andres-tr/BoreholeCamera/README.md

# Borehole Camera

This project aims to create a device capable of exploring water boreholes.
