andres-tr/BoreholeCamera/CAD_Probe/README.md

# Probe CAD

For the probe design it is desired to achieve the following:

 - Waterproof (1000m = 9.883MPa).
 - 90ºC temperature resistant.
 - Low hydronynamic resistance to prevent vibrations while recording.

**Computer asisted desing so far**
 - Explosion
<p align="center">
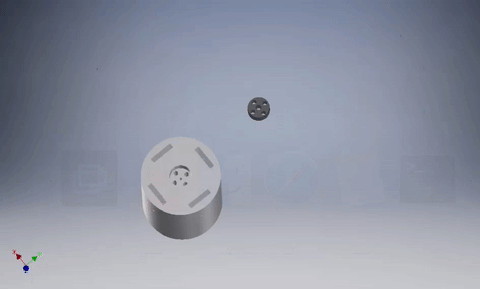
[picture p1: img/Explosion1.gif]
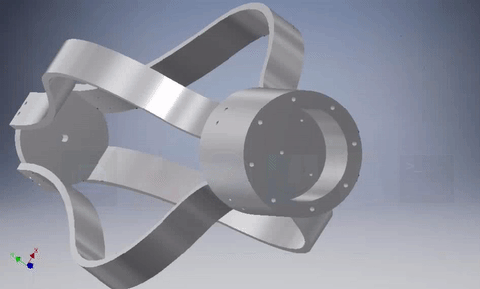
[picture p2: img/Explosion2.gif]
  
</p>

 - Assembly
<p align="center">
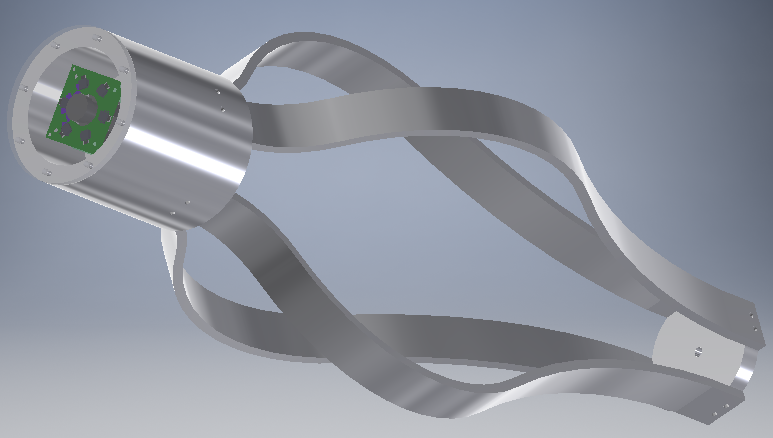
[picture p3: img/Assembly1.png]
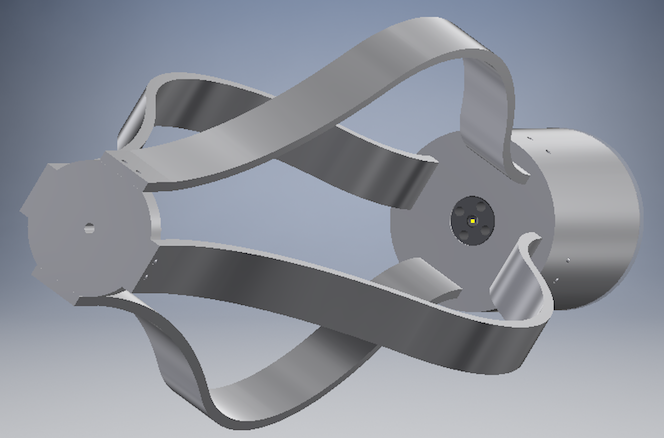
[picture p4: img/Assembly2.png]
  
</p>

 - Section View
<p align="center">
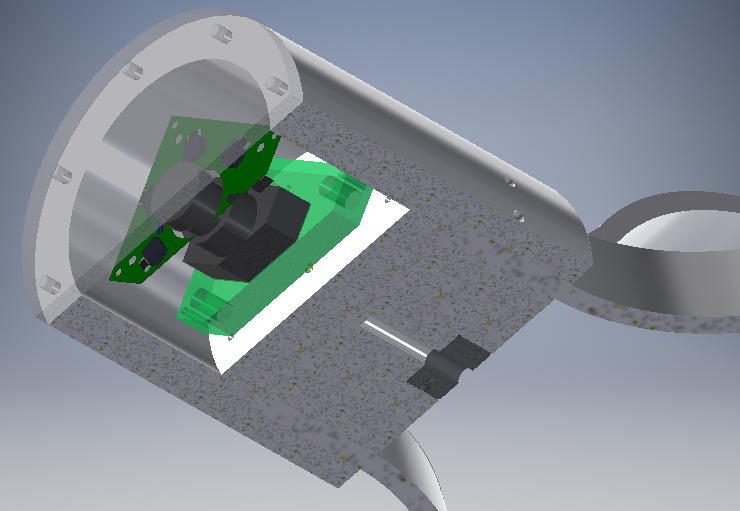
[picture p5: img/SectionView1.png]
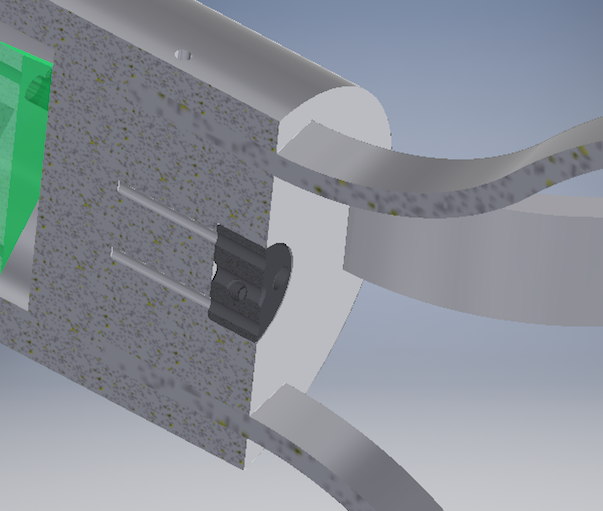
[picture p6: img/SectionView2.png]
  
</p>

**Note:**
