andres-tr/BoreholeCamera/PCB_Probe/README.md

# Probe PCB

Electronics inside the probe have the following characteristics:

 - 750 lumens
 - Minimum power consumption in order to preserve cable condition 
 - PCB designed to provide LEDs around the camera lens evenly

Top side of the PCB

<p align="center">
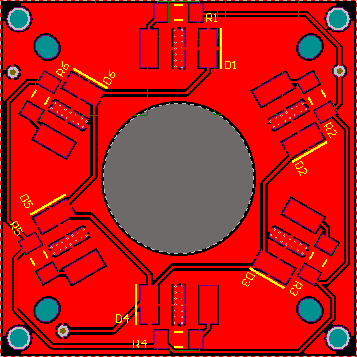
[picture p7: img/PCB_Probe_Top2D.png]
  
</p>

Bottom side of the PCB
<p align="center">
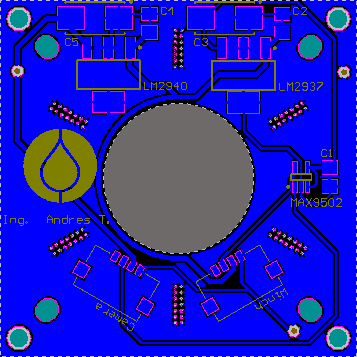
[picture p8: img/PCB_Probe_Bottom2D.png]
  
</p>
