andres-tr/BoreholeCamera/CAD_Probe/PCB/README.md

> - Top side of the PCB

<p align="center">
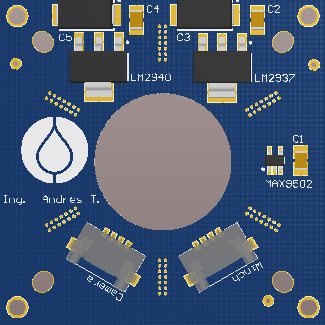
[picture p9: img/PCB_Probe_Top3D.png]
  
</p>

> - Bottom side of the PCB

<p align="center">
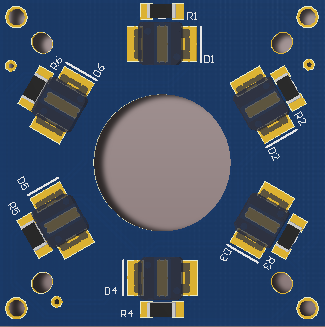
[picture p10: img/PCB_Probe_Bottom3D.png]
  
</p>
