andres-tr/BoreholeCamera/BOM/BOM_Enclosure_Probe.xls

Sheet: Fasteners
Part | Assembly part | Head size | Tool | Lg. | Threaded Lg. A | Thread | Gender | Fit Class | Threaded Lg. B | Thread | Gender | Fit Class | Material | QTY | Extended QTY | Description | Pack size | Number of Packs/Units | McMaster-Carr Part Number | Price Unit/Pack | Extended
6-32 Socket Head Cap Screw | Top cover Screws | 0.226” | 7/64” Hex | 1 1/4” | 1 1/4” | #6-32 | Male | 3A | - | - | - | - | 316 Stainless Steel | 8 | 16 | Type 316 Stainless Steel Socket Head Cap Screw, 6-32 Thread, 1-1/4" Long, Fully Threaded | 10 | 2 | 92185A157 | $6.62 | $13.24
1” long Female Threaded 3/16” Hex Standoff | Camera + LEDS Standoff | 3/16” (Hex) | 3/16” Hex | 1” | 3/16” | #2-56 | Female | 2B | 3/16” | #2-56 | Female | 2B | 18-8 Stainless Steel | 4 | 8 | 18-8 Stainless Steel Female Threaded Hex Standoff, 3/16" Hex Size, 1" Length, 2-56 Thread Size | 1 | 8 | 91115A115 | $2.34 | $18.72
Male Female Threaded Hex Standoff | Camera + LEDS Standoff | 3/16” (Hex) | 3/16” (Hex) | 1” | 3/16” | #2-56 | Female | 2B | 5/32” | #2-56 | Male | 2A | 18-8 Stainless Steel | 4 | 8 | 18-8 Stainless Steel Male-Female Threaded Hex Standoff, 3/16" Hex Size, 1" Length, 2-56 Thread Size | 1 | 8 | 91075A217 | $2.22 | $17.76
2-56 Socket Head Cap Screws | Camera + LEDS fasteners | 0.14” | 5/64” Hex | 1/8” | 1/8” | #2-56 | Male | 3A | - | - | - | - | 316 Stainless Steel | 10 | 20 | Type 316 Stainless Steel Socket Head Cap Screw, 2-56 Thread, 1/8" Long | 10 | 2 | 92185A071 | $5.25 | $10.50
Male Female Threaded Hex Standoffs | Camera + Enclosure Standoff | 3/16” (Hex) | 3/16” Hex | - | 5/32” | #2-56 | Male | 2A | 3/16” | #2-56 | Female | 2B | 18-8 Stainless Steel | 4 | 8 | 18-8 Stainless Steel Male-Female Threaded Hex Standoff, 3/16" Hex Size, 3/8" Length, 2-56 Thread Size | 1 | 8 | 91075A212 | $2.16 | $17.28
2-56 Socket Head Cap Screws | Camera + Enclosure Fasteners | 0.14” | 5/64” Hex | 1/8” | 1/8” | #2-56 | Male | 3A | - | - | - | - | 316 Stainless Steel | 4 | 8 | Type 316 Stainless Steel Socket Head Cap Screw, 2-56 Thread, 1/8" Long | 10 | 1 | 92185A071 | $8.62 | $8.62
6-32 High Hold Cone Point Set Screw | Enclosure + Cable Fasteners | 0.138” | 1/16” Hex | 1/2” | 1/2” | #6-32 | Male | 3A | - | - | - | - | 18-8 Stainless Steel | 8 | 16 | High Hold Cone Point Set Screw, 18-8 Stainless Steel, 6-32 Thread, 1/2" Long | 25 | 1 | 92785A148 | $5.89 | $5.89
Cup Point Set Screw | Enclosure + Fins Fastener | 0.138” | 1/16” Hex | 3/4” | 3/4” | #6-32 | Male | 3A | - | - | - | - | 18-8 Stainless Steel | 8 | 16 | Type 316 Stainless Steel Cup Point Set Screw, 6-32 Thread, 3/4" Long | 25 | 1 | 92313A154 | $7.32 | $7.32
Cup Point Set Screw | Bottom part + Fins Fasteners | 0.138” | 1/16” Hex | 5/8” | 5/8” | #6-32 | Male | 3A | - | - | - | - | 316 Stainless Steel | 4 | 8 | Type 316 Stainless Steel Cup Point Set Screw, 6-32 Thread, 5/8" Long | 25 | 1 | 92313A412 | $6.55 | $6.55
Male – Female Standoff 3.25 mm (0.1279528”) | Winch PCB Standoff | 3/16” (Hex) | 3/16” Hex | - | 1/4” | #6-32 | Male | 2A | 3/8” | #6-32 | Female | 2B | 18-8 Stainless Steel | 4 | 8 | 18-8 Stainless Steel Male-Female Threaded Hex Standoff, 3/16" Hex Size, 3/8" Length, 6-32 Thread Size | 1 | 8 | 91075A112 | $2.16 | $17.28
Male – Female Standoff 6-32 | Winch PCB Standoff | 3/16” (Hex) | 3/16” Hex | - | 1/8” | #6-32 | Male | 2B | 1/4” | #6-32 | Female | 2A | 18-8 Stainless Steel | 4 | 8 | 18-8 Stainless Steel Male-Female Threaded Hex Standoff, 3/16" Hex Size, 1/8" Length, 6-32 Thread Size | 1 | 8 | 91075A874 | $0.98 | $7.84 | *
Narrow Hex nut | Camera lens | 5/32” | 5/32” Hex | - | - | #0-80 | Female | 2B | - | - | - | - | 18-8 Stainless Steel | 2 | 4 | Mil. Spec. 300 Series Stainless Steel Hex Nut, 0-80 Thread Size, 5/32" Wide, 3/64" High, MS-35650-314 | 5 | 1 | 91240A001 | $8.41 | $8.41
Head Cap Screw | Camera lens | 0.05” (Hex) | 0.05” (Hex) | 1/2” | 1/2” | #0-80 | Male | 3A | - | - | - | - | 316 Stainless Steel | 2 | 4 | Type 316 Stainless Steel Socket Head Cap Screw, 0-80 Thread, 1/2" Long | 10 | 1 | 92185A055 | $5.67 | $5.67
Female Standoff | Winch cable holder | 3/16” (Hex) | 3/16” (Hex) | 1” | 3/16” | #2-56 | Female | 2B | 3/16” | #2-56 | Female | 2B | 18-8 Stainless Steel | 5 | 2 | 18-8 Stainless Steel Female Threaded Hex Standoff, 3/16" Hex Size, 1" Length, 2-56 Thread Size | 1 | 2 | 91115A115 | $2.34 | $4.68
 |  |  |  |  |  |  |  |  |  |  |  |  |  |  |  |  |  |  |  | Total | $149.76

Sheet: Tools
Part | Size | For driver style | Driver type | Style | Long Leg | Short Leg | Material | McMaster-Carr Part Number | Description | Pack size | Price Unit/Pack
High-visibility Gold L-Keys 7/64” | 7/64” Hex | Hex | Standard | L-Key | 3 5/8” | 3/4” | Gold-plated steel | 6493A67 | High-Visibility Gold L-Key, 7/64" Size | 1 | $0.61
Precise-control nutdriver 5/32” | 5/32” | 5/32” Hex | Standard | Driver | 2 3/8” | - | Chrome-Plated Steel | 7278A37 | Precise-Control Nutdriver, 5/32" Size | 1 | $5.11
Precise-control nutdrivers 3/16” | 3/16” (Hex) | 3/16” | Standard | Driver | 2 3/8” | - | Chrome-Plated Steel | 7278A38 | Precise-Control Nutdriver, 3/16" Size | 1 | $5.29
High visibility Gold L-Keys 3/16” | 3/16” Hex | Hex | Standard | L-Key | 4 1/2” | 1” | Gold-plated steel | 6493A72 | High-Visibility Gold L-Key, 3/16" Size | 1 | $1.05
High visibility Gold L-Keys 1/8” | 1/8” Hex | Hex | Standard | L-Key | 3 13/16” | 3/4” | Gold-plated steel | 6493A68 | High-Visibility Gold L-Key, 1/8" Size | 1 | $0.61
High visibility Gold L-Keys 1/16” | 1/16” Hex | Hex | Standard | L-Key | 3” | 9/16” | Gold-plated steel | 6493A64 | High-Visibility Gold L-Key, 1/16" Size | 1 | $0.49
Hex L-Key | 0.05 Hex | Hex | Standard | L-Key | 1 5/8” | 9/16” | Steel (Black) | 7122A13 | Hex L-Key, 0.050" Size, 1-11/16" Overall Length | 1 | $0.14
Hex L-Key | 5/64” Hex | Hex | Standard | L-Key | 1 15/16” | 5/8”” | Steel (Black) | 7122A15 | Hex L-Key, 5/64" Size, 2-1/16" Overall Length | 1 | $0.16
 |  |  |  |  |  |  |  |  |  | Total | $13.46

Sheet: Seal
Part | Size | Style | Material | Apple Part Number | Description | QTY | Price Unit | Extended
O-ring (1) | 0.087 x 0.059” | O-ring | Nitril | R00087-059-70BNB | O-ring, .087 x .059 Nitrile, 70A | 20 | $2.60 | $52.00
O-ring (2) | 2.489 x 0.07” | O-ring | Nitril | R02489-070-70BNB | AS568-037 Nitrile, 70A | 20 | $3.00 | $60.00
 |  |  |  |  |  |  | Total | $112.00
