andres-tr/BoreholeCamera/BOM/BOM_PCB.xls

Sheet: PCB_Winch
WINCH
Part | Size/Package | QTY | Extended QTY | Digi-Key Part Number | Manf | Manf Part Number | Description | Price Unit | Extended
MAX7456 | 28-TSSOP | 1 | 4 | MAX7456EUI+-ND | Maxim Integrated | MAX7456EUI+ | IC ON-SCREEN DISPLAY 28-TSSOP | 18.22 | 72.88
27MHZ Crystal | 2-SMD | 1 | 4 | 535-10646-1-ND | Abracon LLC | ABM3-27.000MHZ-D2Y-T | CRYSTAL 27.0000MHZ 18PF SMD | 1.09 | 4.36
0.1 uf Capacitor | 0805 (2012 Metric) | 4 | 16 | 399-1167-1-ND | Kemet | C0805C104K4RACTU | CAP CER 0.1UF 16V X7R 0805 | 0.11 | 1.76
47uf Capacitor | 2917 (7343 Metric) | 2 | 8 | 399-3795-1-ND | Kemet | T491D476K020AT | CAP TANT 47UF 20V 10% 2917 | 1.3 | 10.4
1KΩ Resistor | 0805 (2012 Metric) | 3 | 12 | 311-1.00KCRCT-ND | Yageo | RC0805FR-071KL | RES SMD 1K OHM 1% 1/8W 0805 | 0.1 | 1.2
Female Connector 4 circuits | - | 2 | 8 | WM10655CT-ND | Molex, LLC | 5037630491 | CONN HEADER 1MM R/A 4CKT | 1.13 | 9.04
Male connector 4 circuit | - | 2 | 8 | WM10653-ND | Molex, LLC | 5037640401 | CONN HOUSING 4POS LK | 0.41 | 3.28
Connector Molex (For 4 circuits connectors) | - | 8 | 45 | WM10651CT-ND | Molex, LLC | WM10651CT-ND | CONN TERM FEMALE 28,30AWG | 0.17 | 7.65
Male Conector 7 circuits | - | 1 | 4 | WM10144CT-ND | Molex, LLC | 5040500791 | 7 Positions Header, Shrouded Connector 0.059" (1.50mm) Surface Mount, Right Angle Gold | 1.52 | 6.08
Female Conector 7 circuits | - | 1 | 4 | WM10142-ND | Molex, LLC | 5040510701 | CONN HOUSING 7POS LK | 0.52 | 2.08
Connector Molex (For 7 circuits connectors) | - | 7 | 35 | WM10651CT-ND | Molex, LLC | WM10651CT-ND | CONN TERM FEMALE 28,30AWG | 0.17 | 5.95
Fuse 1A | - | 2 | 8 | 507-1186-1-ND | Bel Fuse Inc. | C1S 1 | FUSE BOARD MNT 1A 63VAC/VDC 1206 | 0.35 | 2.8
Tactile switch | SMD (SMT) Tab | 3 | 12 | P12970SCT-ND | Panasonic Electronic Components | EVQ-Q2F02W | SWITCH TACTILE SPST-NO 0.02A 15V | 0.4 | 4.8
Regu 8V step down | SOT-223-4 | 1 | 4 | 296-41299-1-ND | Texas Instruments | LM2940IMPX-8.0/NOPB | IC REG LDO 8V 1A SOT223 | 2.11 | 8.44
10KΩ Resistor | 0805 (2012 métrico) | 1 | 4 | P16897CT-ND | Panasonic Electronic Components | ERJ-P6WF1002V | RES SMD 10K OHM 1% 1/2W 0805 | 0.59 | 2.36
0.47uf Capacitor | 0805 (2012 Metric) | 1 | 4 | 399-8123-1-ND | Kemet | C0805X474K5RACTU | 0.47µF ±10% 50V X7R Ceramic Capacitor -55°C ~ 125°C Surface Mount, MLCC 0805 (2012 Metric) 0.079" L x 0.049" W (2.00mm x 1.25mm) | 0.72 | 2.88
22uf | 2413 (6032 Metric) | 1 | 4 | 399-3745-1-ND | Kemet | T491C226K020AT | CAP TANT 22UF 20V 10% 2413 | 0.8 | 3.2
Conector (encoder) | - | 1 | 2 | AIMS3106F16S-1S W/P CAP-ND | Amphenol Industrial Operations | MS3106F16S-1S W/P CAP | ER 7C #16S SKT PLUG | 40.54 | 81.08
Video Connector | - | 3 | 12 | CP-1421-ND | CUI Inc. | RCJ-044 | CONN RCA JACK MONO 3.2MM R/A | 1.78 | 21.36
Intel Edison receptacle | - | 1 | 4 | H11908CT-ND | Hirose Electric Co Ltd | DF40C(2.0)-70DS-0.4V(51) | CONN RCPT 70POS 0.4MM SMD GOLD | 1.37 | 5.48
Power jack connector dip | - | 1 | 4 | A118043CT-ND | TE Connectivity AMP Connectors | 1-2129345-1 | DC POWER JACK CONN DIP TYPE | 2.62 | 10.48
Power jack plug connector | - | 1 | 4 | A118213-ND | TE Connectivity AMP Connectors | 1-2129334-1 | DC POWER PLUG CONN | 2.48 | 9.92
Headers 10 circuits | - | 2 | 8 | 952-1843-ND | Harwin Inc. | M20-9991046 | 10 Positions Header, Unshrouded, Breakaway Connector 0.100" (2.54mm) Through Hole Tin | 0.29 | 2.32
Headers 6 circuits | - | 2 | 8 | A106757-ND | TE Connectivity AMP Connectors | 826926-6 | 6 Positions Header, Unshrouded, Breakaway Connector 0.100" (2.54mm) Through Hole Tin | 0.44 | 3.52
Female Conector 2 Circuits for push buttons | - | 3 | 12 | WM10652-ND | Molex, LLC | 5037640201 | CONN HOUSING 2POS LK | 0.22 | 2.64
Male Conector 2 Circuits for push buttons | - | 3 | 12 | WM10654CT-ND | Molex, LLC | 5037630291 | 2 Positions Header, Shrouded Connector 0.039" (1.00mm) Surface Mount, Right Angle Gold | 0.83 | 9.96
Connector Molex for 2 circuits | - | 6 | 28 | WM10651CT-ND | Molex, LLC | WM10651CT-ND | CONN TERM FEMALE 28,30AWG | 0.17 | 4.76
Extended quantity 4 PCB
Part | Size/Package | QTY | Extended QTY | Newark Part Number | Manf | Manf Part Number | Description | Price Unit | Extended
1k res | 0805 [2012 Metric] | 3 | 20 | 65J1337 | vishay | CRCW08051K00JNEB | The Vishay D/CRCW e3 series are standard thick film chip resistors. | 0.105 $ | 2.100 $
330 ohm 1W (290OHMS 0.029W) | 0805 [2012 Metric] | 1 | 10 | 58K4809 | multicomp | MC01W08051330R | 100mW 150v | 0.003 $ | 0.030 $
RES 300 ohms (290 0.029W) | 0603 [1608 Metric] | 1 | 10 | 58K4556 | multicomp | MC0063W06031300R | 63mW 50 V | 0.002 $ | 0.020 $
RES 75 ohm | 0805 [2012 Metric] | 2 | 25 | 65T8842 | Panasonic Electronic Components | ERJ-6GEYJ750V | 125mW 150V 75ohm | 0.004 $ | $0.10

Sheet: PCB_Probe
PROBE
Part | Size/Package | QTY | Extended QTY | Digi-Key Part Number | Manf | Manf Part Number | Description | Price Unit | Extended
MAX9502M 12DB | 5-TSSOP, SC-70-5, SOT-353 | 1 | 4 | MAX9502MEXK+TCT-ND | Maxim Integrated | MAX9502MEXK+T | IC AMP VIDEO W/FILTER SC70-5 | 1.22 | 4.88
0.1 uf Capacitor | 0805 (2012 Metric) | 2 | 8 | 399-1167-1-ND | Kemet | C0805C104K4RACTU | CAP CER 0.1UF 16V X7R 0805 | 0.11 | 0.88
Female Connector | - | 2 | 8 | WM10655CT-ND | Molex, LLC | 5037630491 | CONN HEADER 1MM R/A 4CKT | 1.13 | 9.04
Male connector | - | 2 | 8 | WM10653-ND | Molex, LLC | 5037640401 | CONN HOUSING 4POS LK | 0.41 | 3.28
Connector Molex | - | 16 | 70 | WM10651CT-ND | Molex, LLC | WM10651CT-ND | CONN TERM FEMALE 28,30AWG | 0.17 | 11.9
Reg 3.3V | SOT-223 | 1 | 4 | LM2937IMP-3.3CT-ND | Texas Instruments | LM2937IMP-3.3 | IC REG LDO 3.3V 0.4A SOT223 | 2.11 | 8.44
cap 10uF | 2413 (6032 Metric) | 1 | 4 | 399-3732-1-ND | Kemet | T491C106K016AT | CAP TANT 10UF 16V 10% 2413 | 0.53 | 2.12
LED neutral White | 2-SMD | 6 | 24 | MX3SWT-A1-0000-000CE5CT-ND | Cree Inc. | MX3SWT-A1-0000-000CE5 | LED XLAMP NEUTRAL WHT 4000K 2SMD | 1.33 | 31.92
LED cool white | 2-SMD | 6 | 24 | MX3SWT-A1-0000-000E51CT-ND | Cree Inc. | MX3SWT-A1-0000-000E51 | LED XLAMP COOL WHITE 6500K 2SMD | 2.24 | 53.76
LED white warm | 2-SMD | 6 | 24 | MX3SWT-A1-R250-000BE7CT-ND | Cree Inc. | MX3SWT-A1-R250-000BE7 | LED XLAMP WARM WHITE 3000K 2SMD | 1.22 | 29.28
Res 12 ohm | 1206 (3216 Metric) | 6 | 24 | P12ECT-ND | Panasonic Electronic Components | ERJ-8GEYJ120V | RES SMD 12 OHM 5% 1/4W 1206 | 0.1 | 2.4
Reg 12V step down | SOT-223-4 | 1 | 4 | LM2940IMP-12/NOPBCT-ND | Texas Instruments | LM2940IMP-12/NOPB | IC REG LDO 12V 1A SOT223 | 2.11 | 8.44
0.47uf Capacitor | 0805 (2012 Metric) | 1 | 4 | 399-8123-1-ND | Kemet | C0805X474K5RACTU | 0.47µF ±10% 50V X7R Ceramic Capacitor -55°C ~ 125°C Surface Mount, MLCC 0805 (2012 Metric) 0.079" L x 0.049" W (2.00mm x 1.25mm) | 0.72 | 2.88
22uf | 2413 (6032 Metric) | 1 | 4 | 399-3745-1-ND | Kemet | T491C226K020AT | CAP TANT 22UF 20V 10% 2413 | 0.8 | 3.2
*Extended quantity 4 PCB

Sheet: Tools
Tools
Part | QTY | Newark Part Number | Manf | Manf Part Number | Description | Price Unit | Extended
Adjustable Wrist strap scs | 1 | 39M5815 | SCS | ECWS61M-1 | The ECWS61M-1 is an Adjustable Fabric Wristband with 6ft cord. This economy wrist strap provides a cost effective means of grounding production staff. Features an adjustable fabric wristband, a 6 foot retractable coil cord, a 4mm snap and a spinning banana plug. | $7.36 | $7.36
Straight Tweezers | 1 | 48F2399 | Erem | EROPSSSA | Stainless Steel Punta Recta Puntiaguda | $5.66 | $5.66
Curved Tweezers | 1 | 71C3124 | Duratool | 1PK-106T-F | Stainless Steel | $5.75 | $5.75
Solder paste | 1 | 84R8667 | Chip Quick | SMD291SNL10 | Solder Paste, Water Washable, 217 C, 35 g | $36.81 | $36.81
Flux pen | 2 | 82H2047 | Kester | 83-1000-0951 | low-solid no-clean Flux Pen, specifically designed for rework of conventional and surface mount circuit board assemblies. | $13.02 | $26.04
Hot air rework station | 1 | 93T8993 | Tenma | 21-11425 | The 21-11425 is a compact-sized hot air Rework Station with closed loop control, LED display and modulated air flow making it ideal for multiple applications. Fast and stable temperature rise add to the convenience. | $102.29 | $102.29
Micropoint long soldering tip | 2 | 51F3536 | Weller | ET-S | The ET-S from Weller is a micropoint long soldering tip. This tip is used with Weller LR soldering iron. | $5.08 | $10.16
Wire cutter | 1 | 39C0516 | MCM | 22-595 | Wire cutter | $8.35 | $8.35
