andres-tr/BoreholeCamera/CAD_Probe/Assembly/STL/Assembly.stl

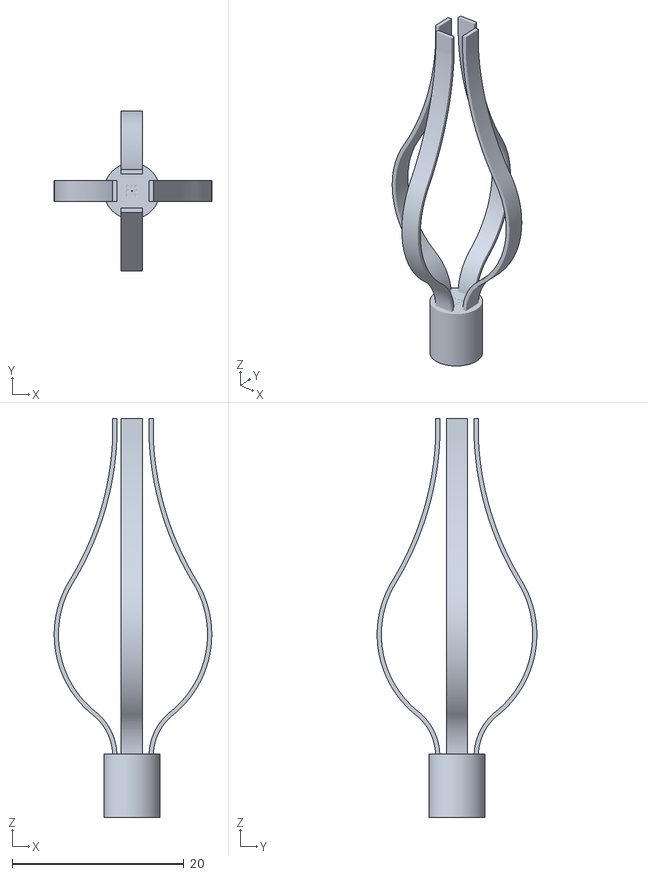
[picture p11: CAD file, 2016-06-02]
CAD_Probe/Assembly/STL/Assembly.stl
18.4 x 18.6 x 46.5
