andres-tr/BoreholeCamera/CAD_Probe/Camera/Assembly/STEP/Assembly.stp

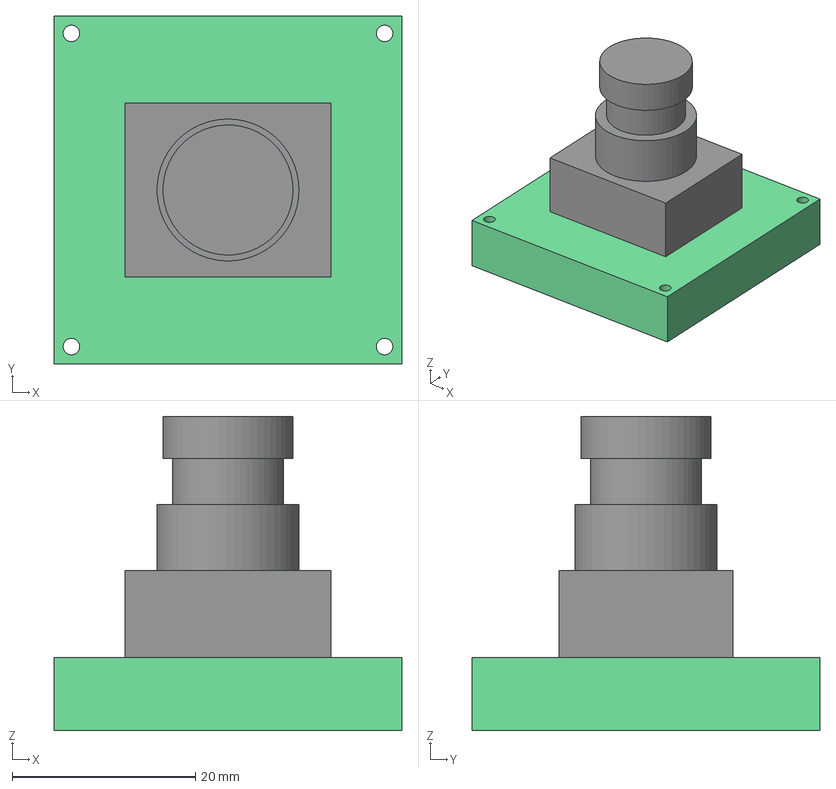
[picture p12: CAD file, 2016-04-14]
CAD_Probe/Camera/Assembly/STEP/Assembly.stp
38.0 x 38.0 x 34.3 mm
PCB_Camera
Camera
