andres-tr/BoreholeCamera/CAD_Probe/Camera/Parts/STEP/Camera.stp

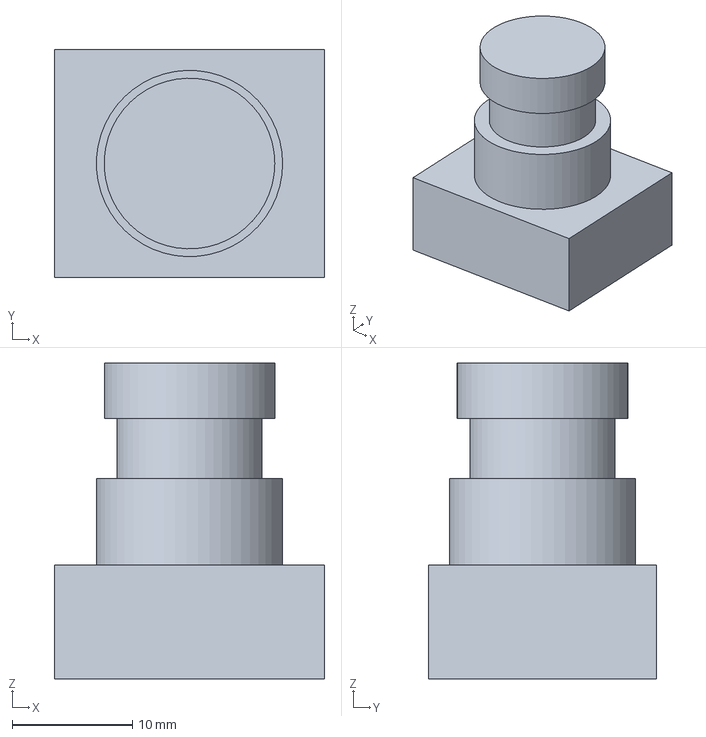
[picture p13: CAD file, 2016-04-14]
CAD_Probe/Camera/Parts/STEP/Camera.stp
22.5 x 19.0 x 26.3 mm
