andres-tr/BoreholeCamera/CAD_Probe/Enclosure/Parts/STL/Cover.stl

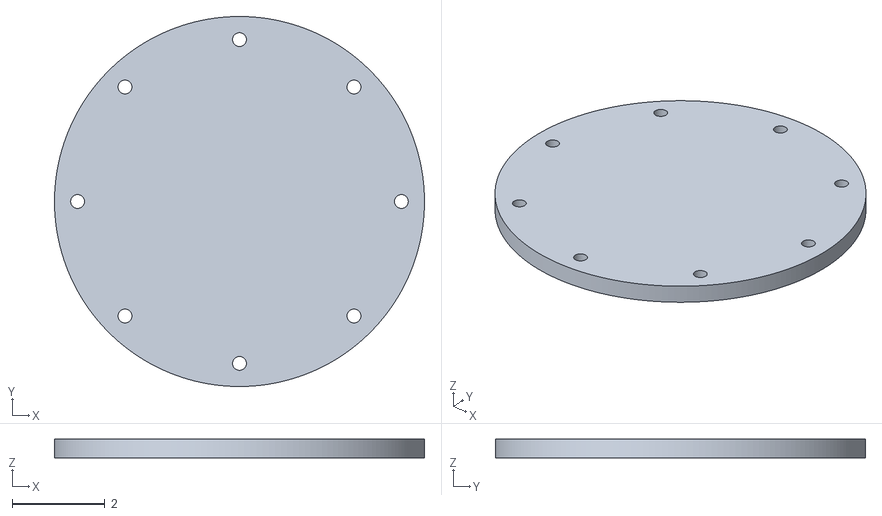
[picture p14: CAD file, 2016-06-25]
CAD_Probe/Enclosure/Parts/STL/Cover.stl
8.00 x 8.00 x 0.4
