andres-tr/BoreholeCamera/CAD_Probe/Laser/stl/laserCapBottom.stl

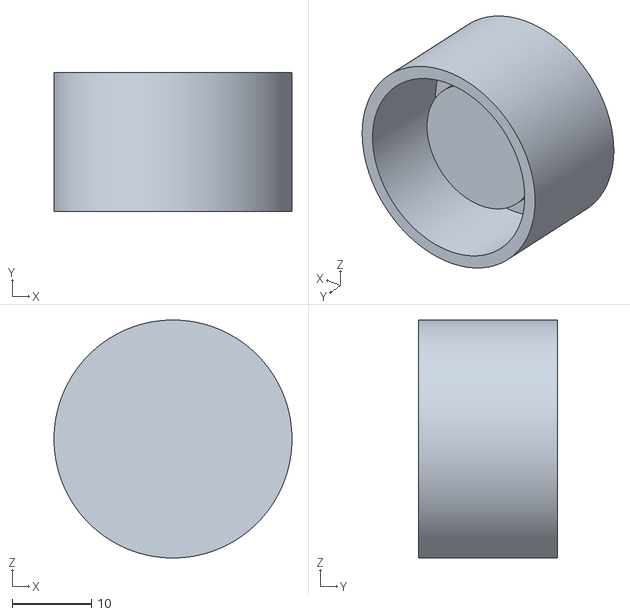
[picture p15: CAD file, 2018-11-16]
CAD_Probe/Laser/stl/laserCapBottom.stl
30.0 x 17.5 x 30.0
