andres-tr/BoreholeCamera/CAD_Probe/PCB/STL/PCB_Probe.stl

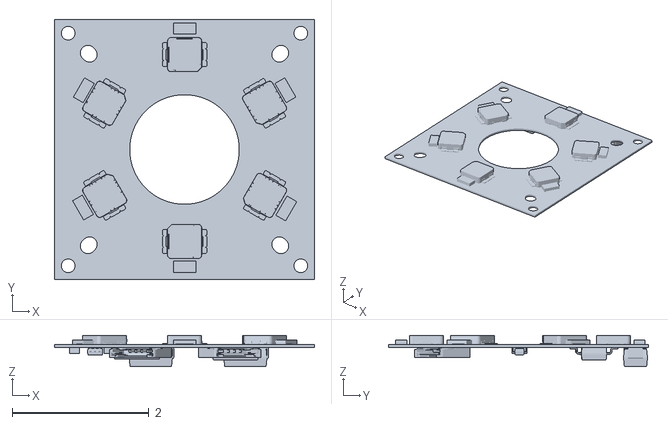
[picture p16: CAD file, 2016-06-25]
CAD_Probe/PCB/STL/PCB_Probe.stl
3.80 x 3.80 x 0.456
