andres-tr/BoreholeCamera/CAD_Probe/Camera/Parts/STEP/PCB_Camera.stp

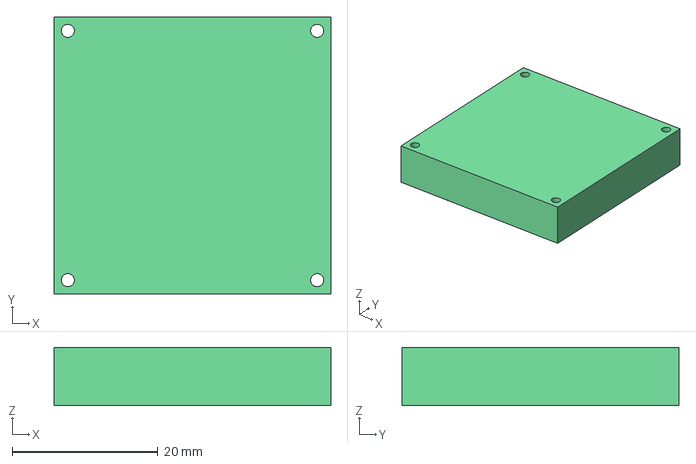
[picture p17: CAD file, 2016-04-14]
CAD_Probe/Camera/Parts/STEP/PCB_Camera.stp
38.0 x 38.0 x 8.00 mm
