andres-tr/BoreholeCamera/CAD_Probe/Enclosure/Parts/STL/Enclosure.stl

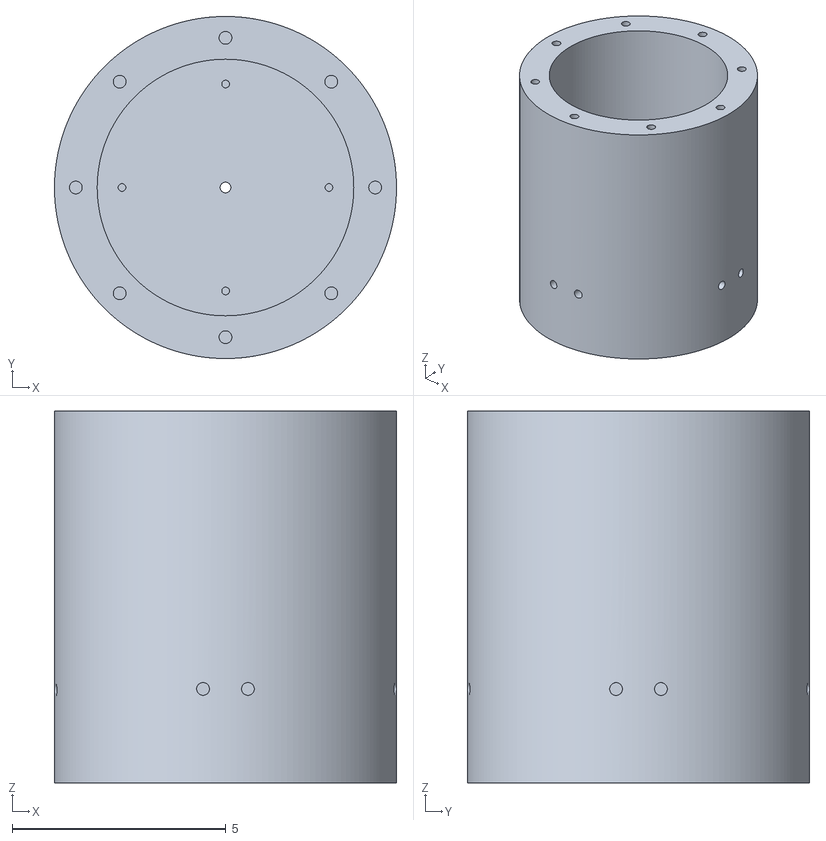
[picture p18: CAD file, 2016-06-25]
CAD_Probe/Enclosure/Parts/STL/Enclosure.stl
8.00 x 8.00 x 8.70
