andres-tr/BoreholeCamera/CAD_Probe/Laser/stl/laserNut.stl

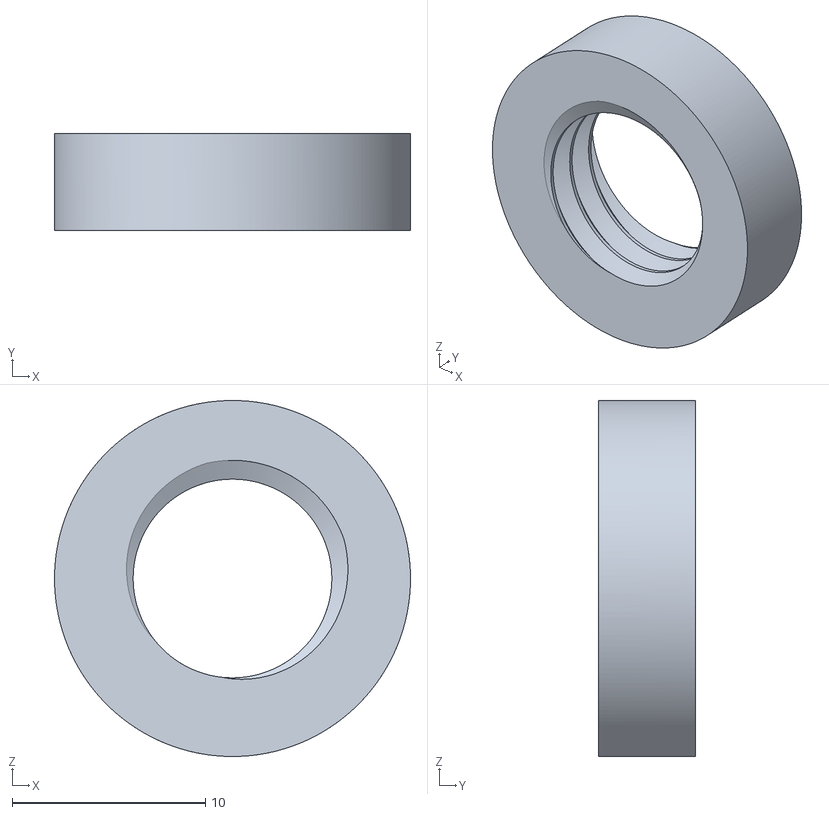
[picture p19: CAD file, 2018-11-16]
CAD_Probe/Laser/stl/laserNut.stl
18.4 x 5.00 x 18.4
