andres-tr/BoreholeCamera/CAD_Probe/Enclosure/Parts/STL/Bottom.stl

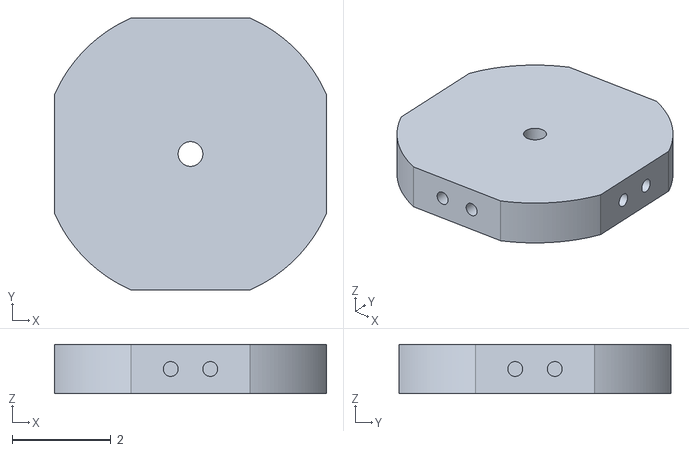
[picture p20: CAD file, 2016-06-25]
CAD_Probe/Enclosure/Parts/STL/Bottom.stl
5.50 x 5.50 x 1.00
