andres-tr/BoreholeCamera/CAD_Probe/Laser/stl/laserCapTop.stl

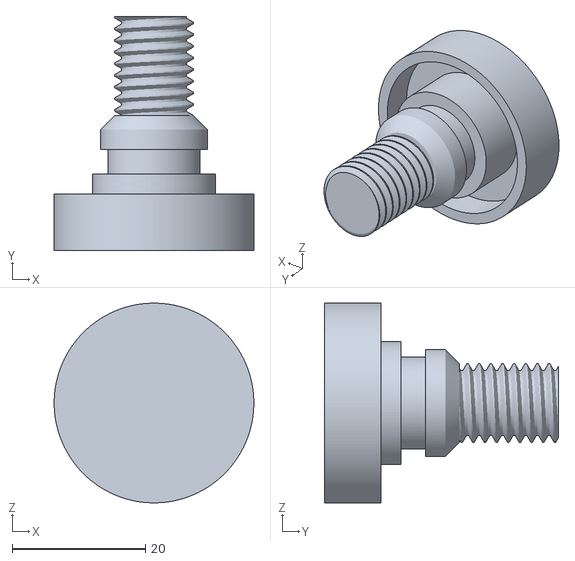
[picture p21: CAD file, 2018-11-16]
CAD_Probe/Laser/stl/laserCapTop.stl
30.0 x 35.2 x 30.0
