andres-tr/BoreholeCamera/CAD_Probe/Enclosure/Parts/STL/8inch_Fin.stl

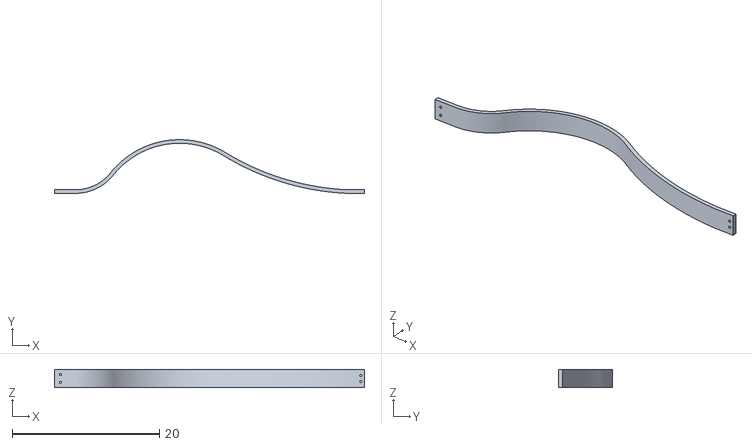
[picture p22: CAD file, 2016-06-25]
CAD_Probe/Enclosure/Parts/STL/8inch_Fin.stl
42.2 x 7.30 x 2.50
