andres-tr/BoreholeCamera/CAD_Probe/Assembly/Fasteners/STEP/92313A412_TYPE 316 SS CUP POINT SET SCREW.STEP

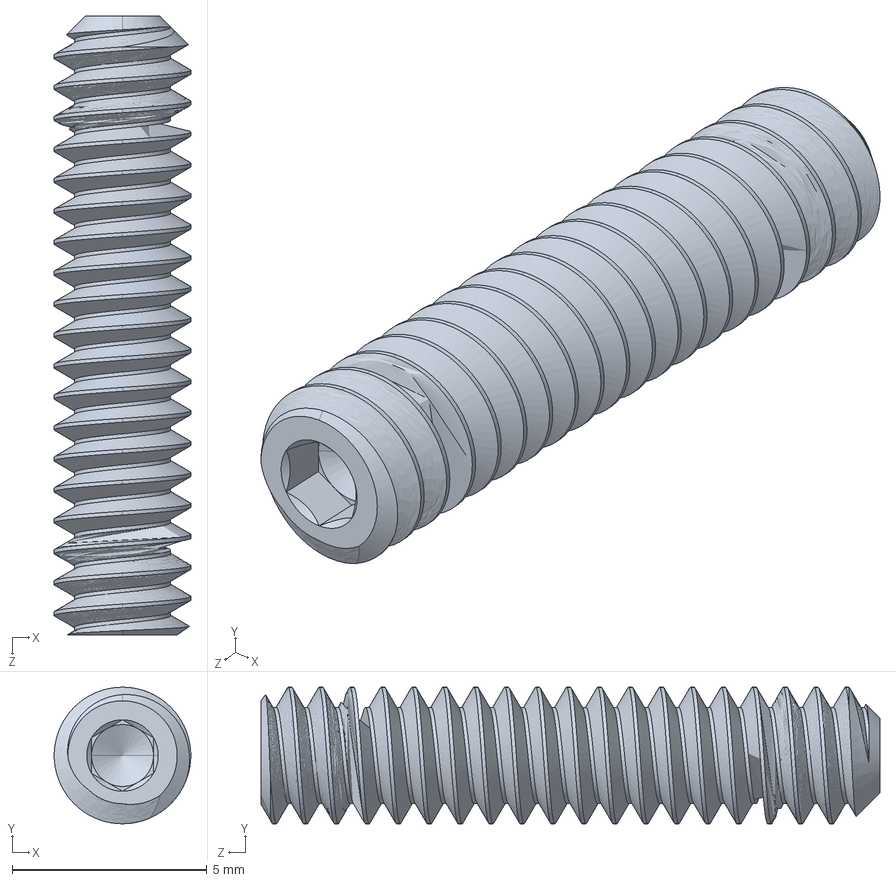
[picture p23: CAD file, 2016-09-23]
CAD_Probe/Assembly/Fasteners/STEP/92313A412_TYPE 316 SS CUP POINT SET SCREW.STEP
3.50 x 3.51 x 15.9 mm
