andres-tr/BoreholeCamera/CAD_Probe/Enclosure/Parts/STEP/91075A212_18-8 SS MALE-FEM THRDED HEX STANDOFF.STEP

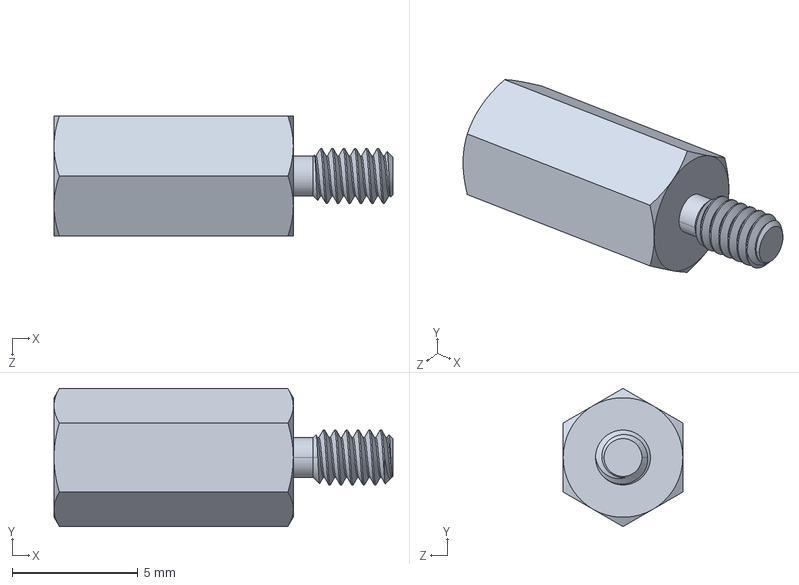
[picture p24: CAD file, 2016-07-28]
CAD_Probe/Enclosure/Parts/STEP/91075A212_18-8 SS MALE-FEM THRDED HEX STANDOFF.STEP
13.5 x 5.50 x 4.76 mm
