andres-tr/BoreholeCamera/CAD_Probe/Enclosure/Parts/STEP/90910A680_LOW-PROFILE BUTTON HEAD TORX MACHINE SCREW.STEP

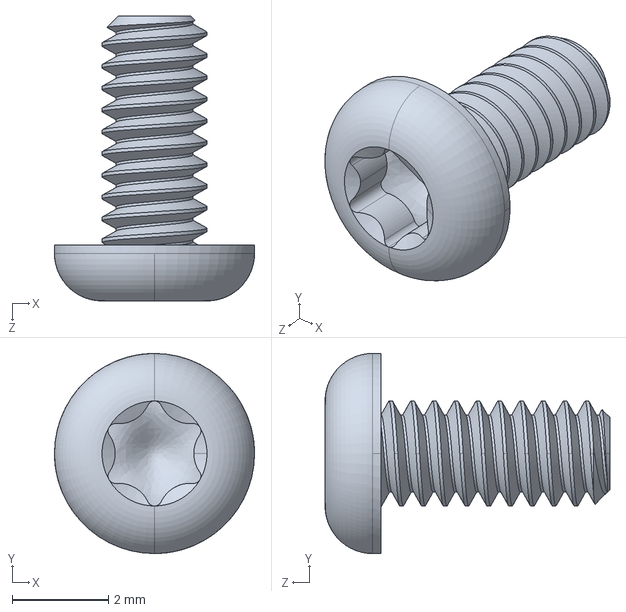
[picture p25: CAD file, 2016-07-28]
CAD_Probe/Enclosure/Parts/STEP/90910A680_LOW-PROFILE BUTTON HEAD TORX MACHINE SCREW.STEP
4.17 x 4.17 x 5.93 mm
