andres-tr/BoreholeCamera/CAD_Probe/Enclosure/Parts/STEP/TYPE 316 SS SOCKET HEAD CAP SCREW.STEP

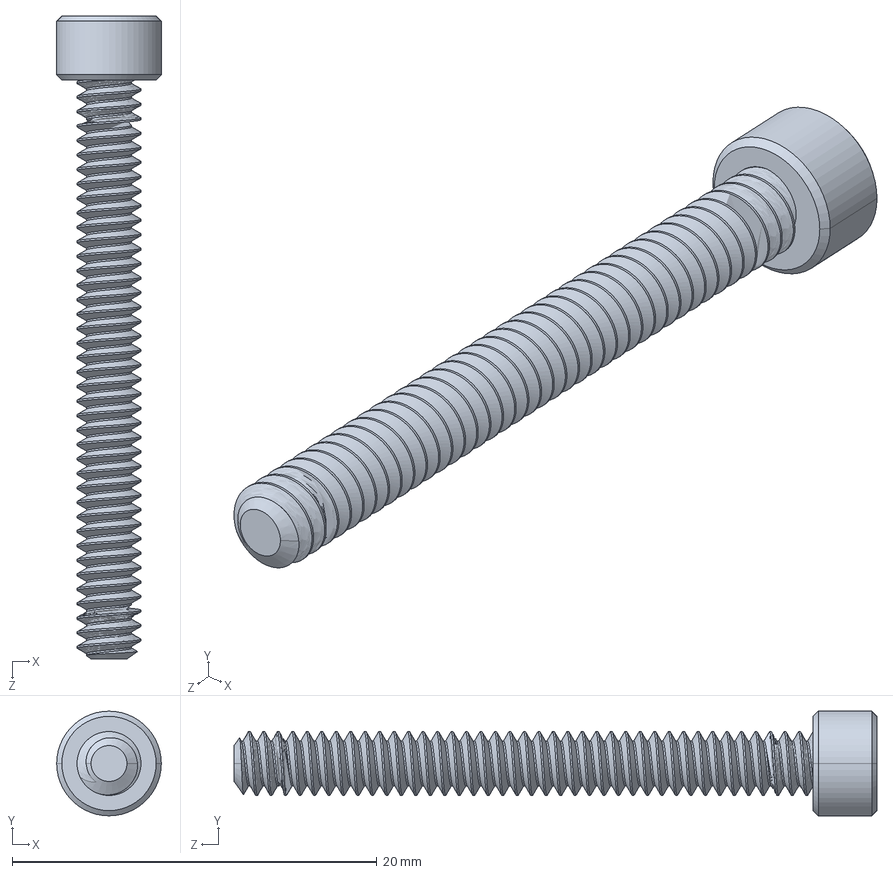
[picture p26: CAD file, 2016-07-28]
CAD_Probe/Enclosure/Parts/STEP/TYPE 316 SS SOCKET HEAD CAP SCREW.STEP
5.74 x 5.74 x 35.3 mm
