andres-tr/BoreholeCamera/(list of files, cad)

Other CAD files:
CAD_Probe/Drawing/Assembly.dwg
CAD_Probe/Drawing/Enclosure.dwg
CAD_Probe/Assembly/Assembly.iam
CAD_Probe/Assembly/Explosion/Explosion.ipn
CAD_Probe/Assembly/Explosion/tmp.ipn
CAD_Probe/Camera/Assembly/Assembly.iam
CAD_Probe/Camera/Assembly/STL/Assembly.stl
CAD_Probe/Camera/Parts/Camera.ipt
CAD_Probe/Camera/Parts/PCB_Camera.ipt
CAD_Probe/Camera/Parts/STL/Camera.stl
CAD_Probe/Camera/Parts/STL/PCB_Camera.stl
CAD_Probe/Drawing/Drawing.idw
CAD_Probe/Enclosure/Assembly/Assembly1.iam
CAD_Probe/Enclosure/Assembly/Assembly1/Design Accelerator/O-Ring1.iam
CAD_Probe/Enclosure/Assembly/Assembly1/Design Accelerator/O-Ring2.iam
CAD_Probe/Enclosure/Assembly/Assembly1/Design Accelerator/O-Ring3.iam
CAD_Probe/Enclosure/Assembly/Assembly1/Design Accelerator/O-Ring4.iam
CAD_Probe/Enclosure/Assembly/Assembly1/Design Accelerator/O-Ring6.iam
CAD_Probe/Enclosure/Assembly/Cover.iam
CAD_Probe/Enclosure/Assembly/Explosion/Explosion.ipn
CAD_Probe/Enclosure/Parts/8inch_Fin.ipt
CAD_Probe/Enclosure/Parts/90910A680_LOW-PROFILE BUTTON HEAD TORX MACHINE SCREW.ipt
CAD_Probe/Enclosure/Parts/91075A212_18-8 SS MALE-FEM THRDED HEX STANDOFF.ipt
CAD_Probe/Enclosure/Parts/91115A816_18-8 SS FEM THRDED HEX STANDOFF.ipt
CAD_Probe/Enclosure/Parts/92185A071_TYPE 316 SS SOCKET HEAD CAP SCREW.ipt
CAD_Probe/Enclosure/Parts/92313A154_TYPE 316 SS CUP POINT SET SCREW.ipt
CAD_Probe/Enclosure/Parts/92313A412_TYPE 316 SS CUP POINT SET SCREW.ipt
CAD_Probe/Enclosure/Parts/92785A148_HIGH HOLD CONE POINT SET SCREW.ipt
CAD_Probe/Enclosure/Parts/AS 568 - DASH # 004(1).ipt
CAD_Probe/Enclosure/Parts/AS 568 - DASH # 201(1).ipt
CAD_Probe/Enclosure/Parts/Bottom.ipt
CAD_Probe/Enclosure/Parts/Cover.ipt
CAD_Probe/Enclosure/Parts/CoverPart1.ipt
CAD_Probe/Enclosure/Parts/CoverPart2.ipt
CAD_Probe/Enclosure/Parts/CoverPart3.ipt
CAD_Probe/Enclosure/Parts/CoverPart4.ipt
CAD_Probe/Enclosure/Parts/Enclosure.ipt
CAD_Probe/Enclosure/Parts/Fin.ipt
CAD_Probe/Enclosure/Parts/SealCover.ipt
CAD_Probe/Enclosure/Parts/TYPE 316 SS SOCKET HEAD CAP SCREW.ipt
CAD_Probe/Laser/origin/laserCapBottom.f3d
CAD_Probe/Laser/origin/laserCapTop.f3d
CAD_Probe/Laser/origin/laserNut.f3d
