andres-tr/BoreholeCamera/CAD_Probe/Drawing/PDF/Drawing.pdf

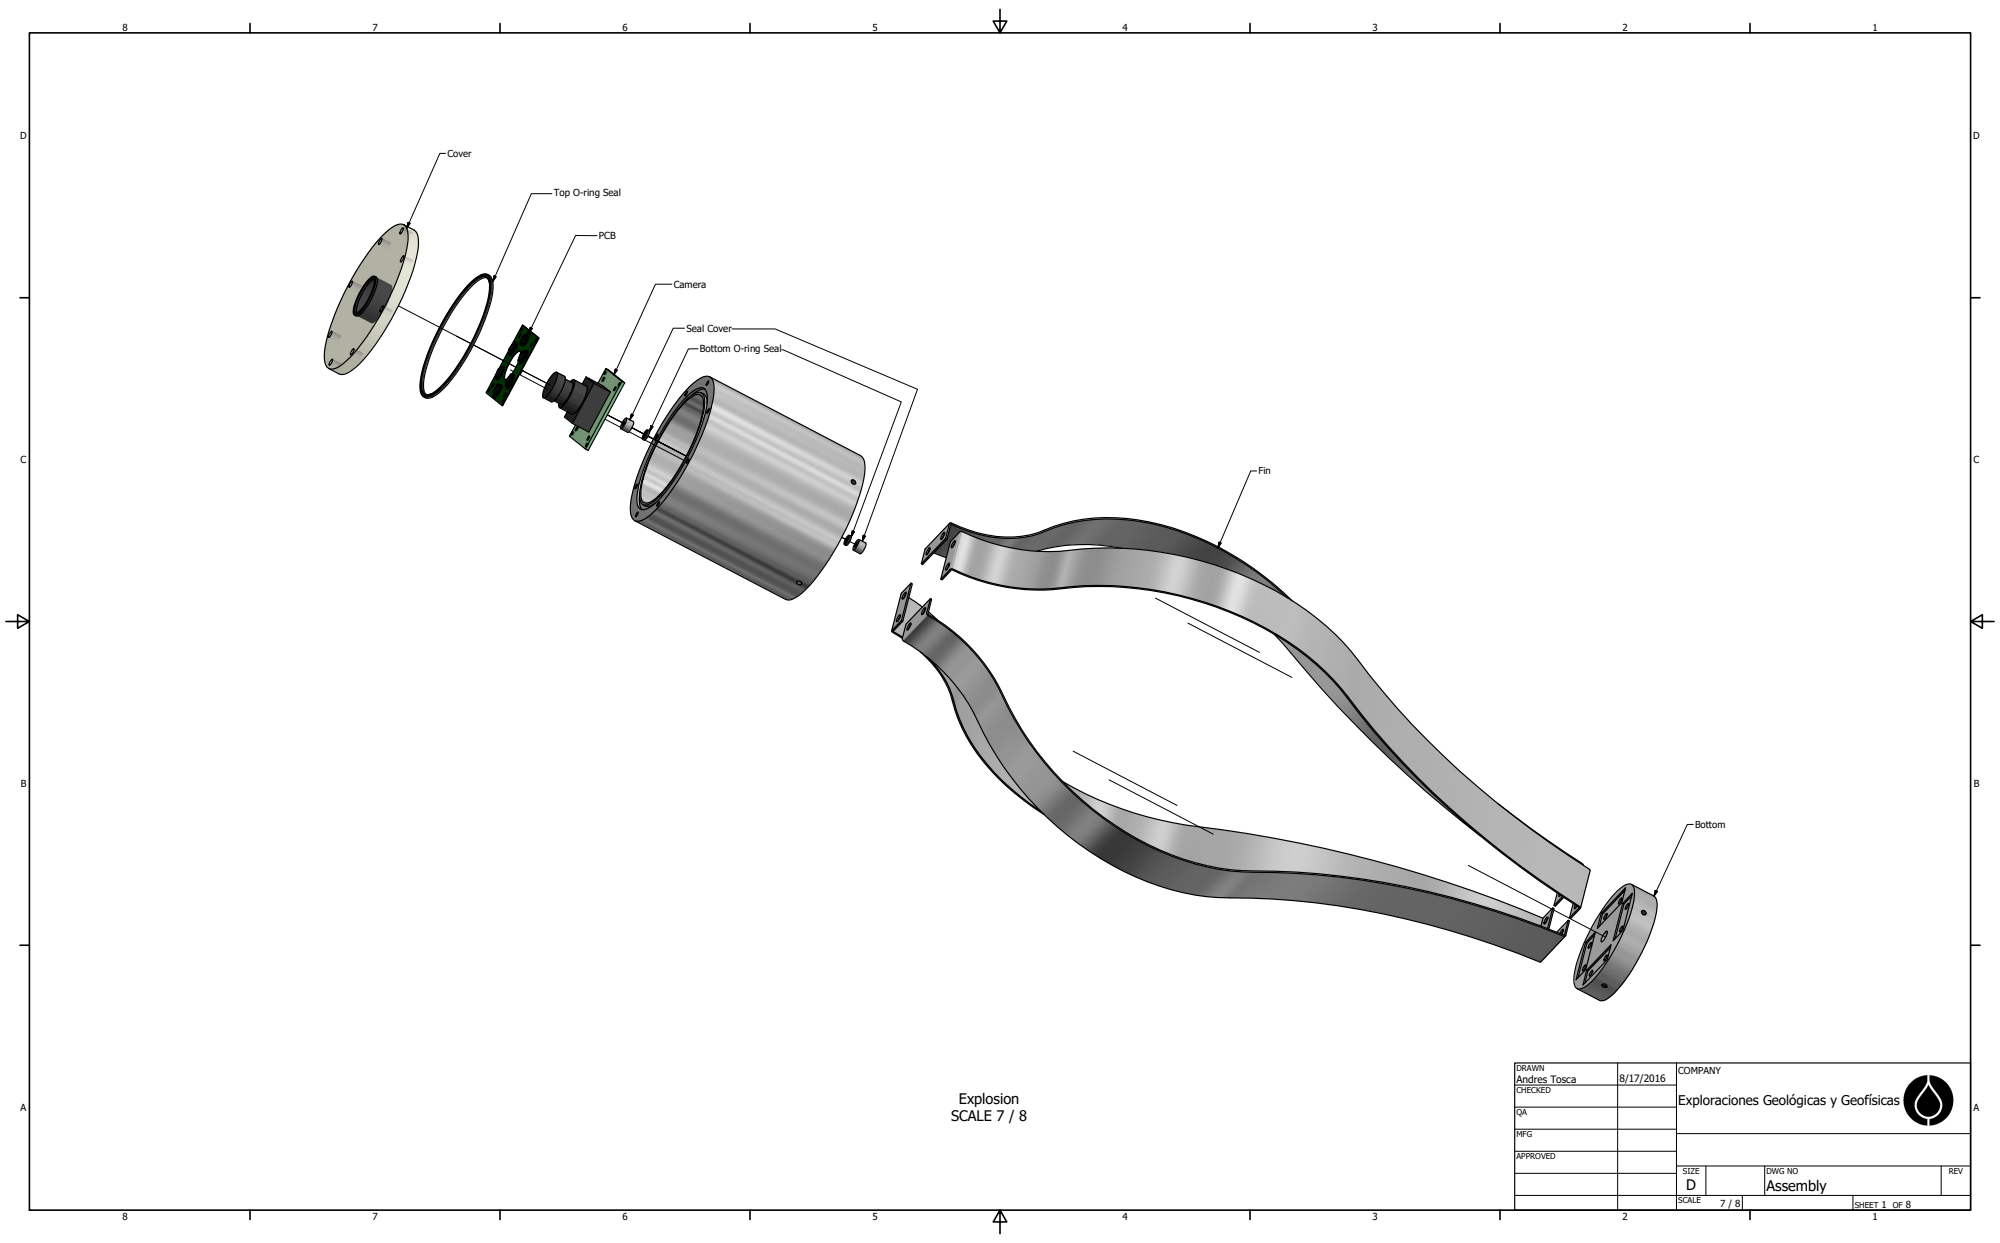
[picture p27: page 1]
Explosion SCALE 7 / 8; SHEET 1 OF 8; DRAWN; CHECKED; MFG; APPROVED; Andres Tosca; DWG NO Assembly; SIZE D; SCALE; REV; COMPANY; PCB; Camera; Seal Cover; Cover; Fin; Bottom

Top O-ring Seal

Bottom O-ring Seal

Exploraciones Geolygicas y Geoftsicas

## Cover SCALE 1 : 1

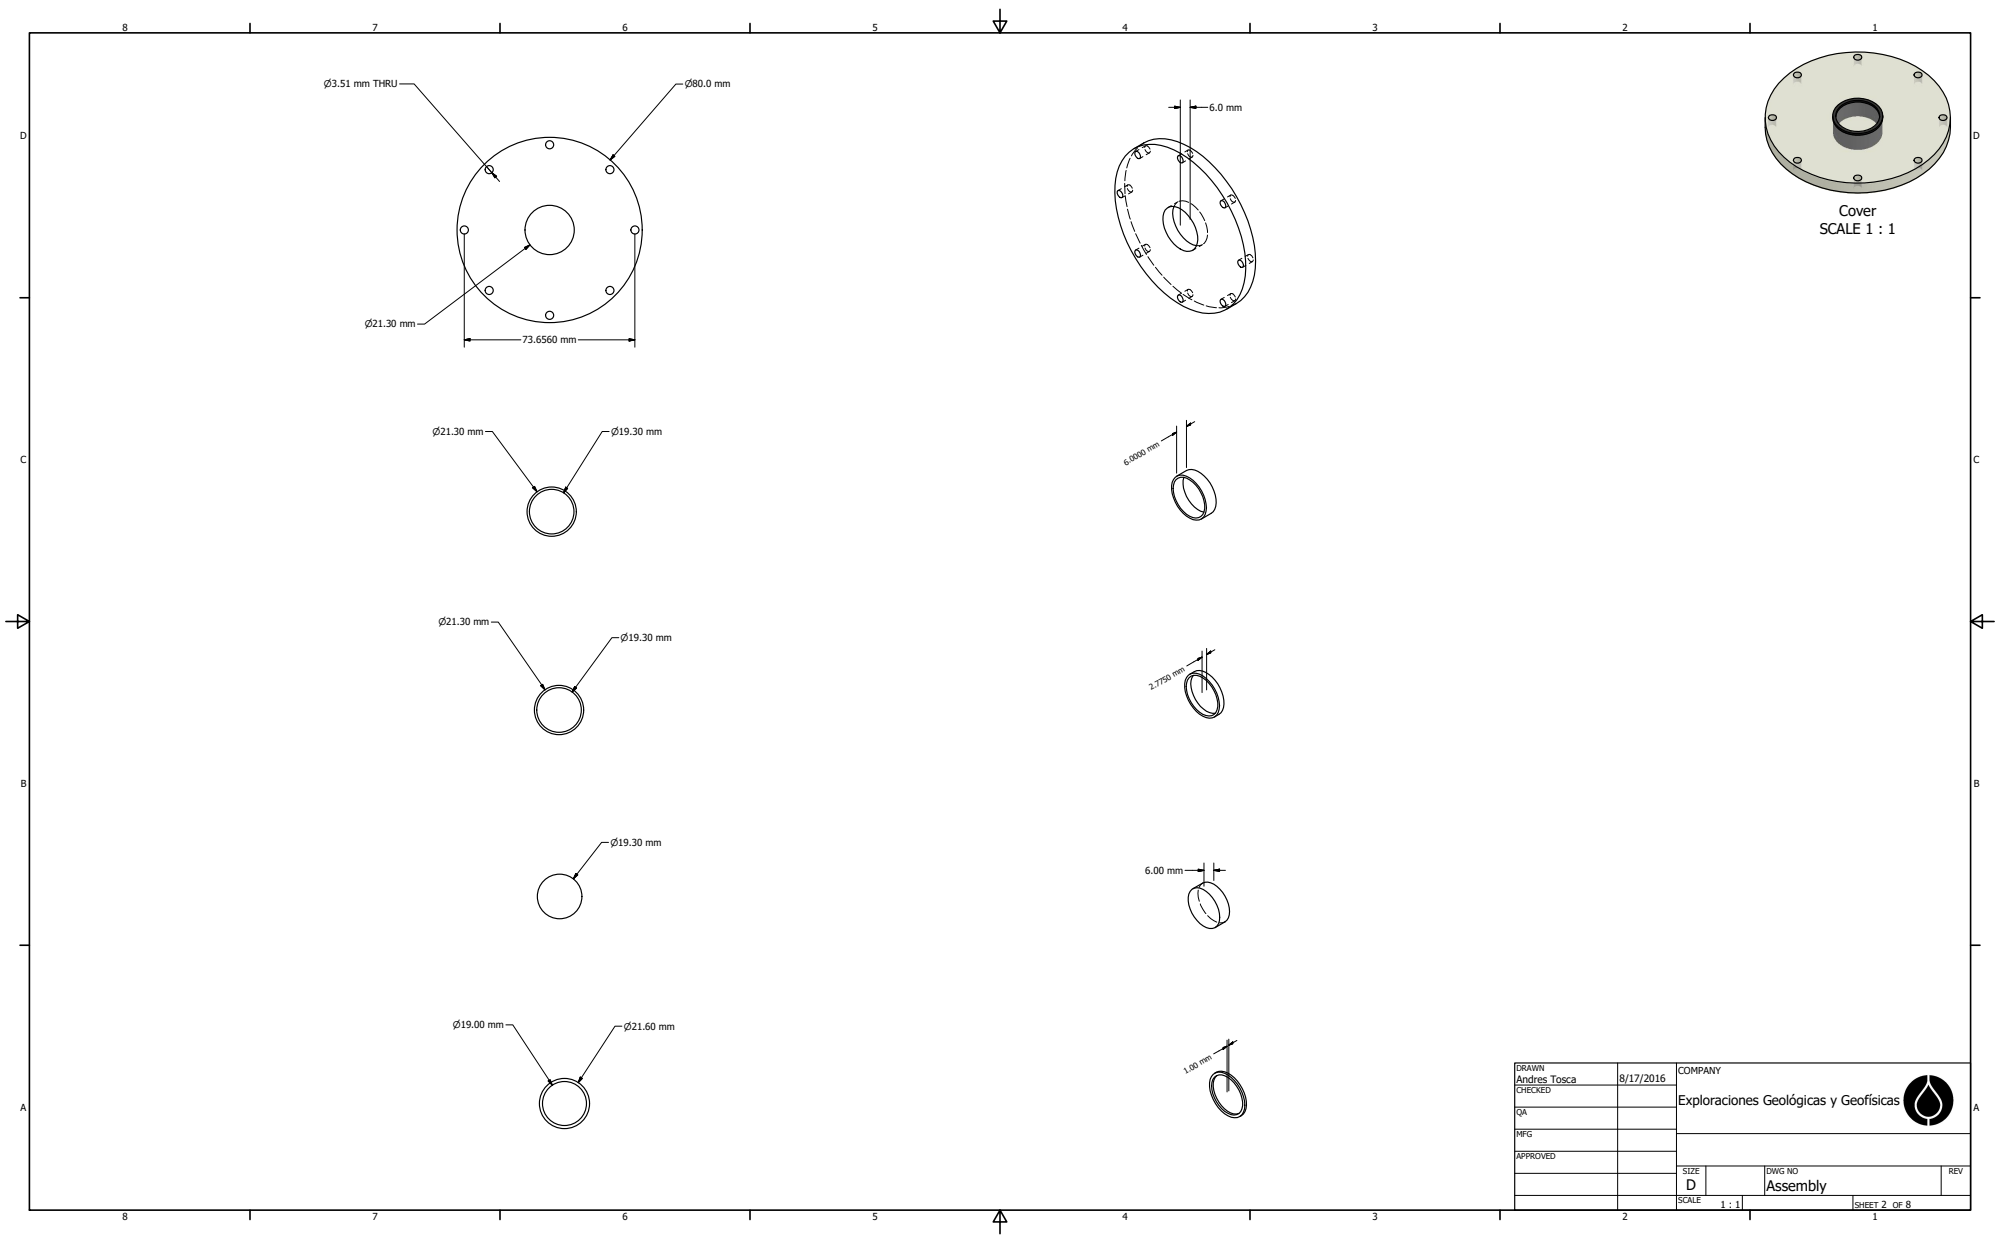
[picture p28: page 2]
DRAWN; CHECKED; MFG; Andres Tosca; COMPANY; P3.51 mm THRU

Exploraciones Geolygicas y Geoftsicas

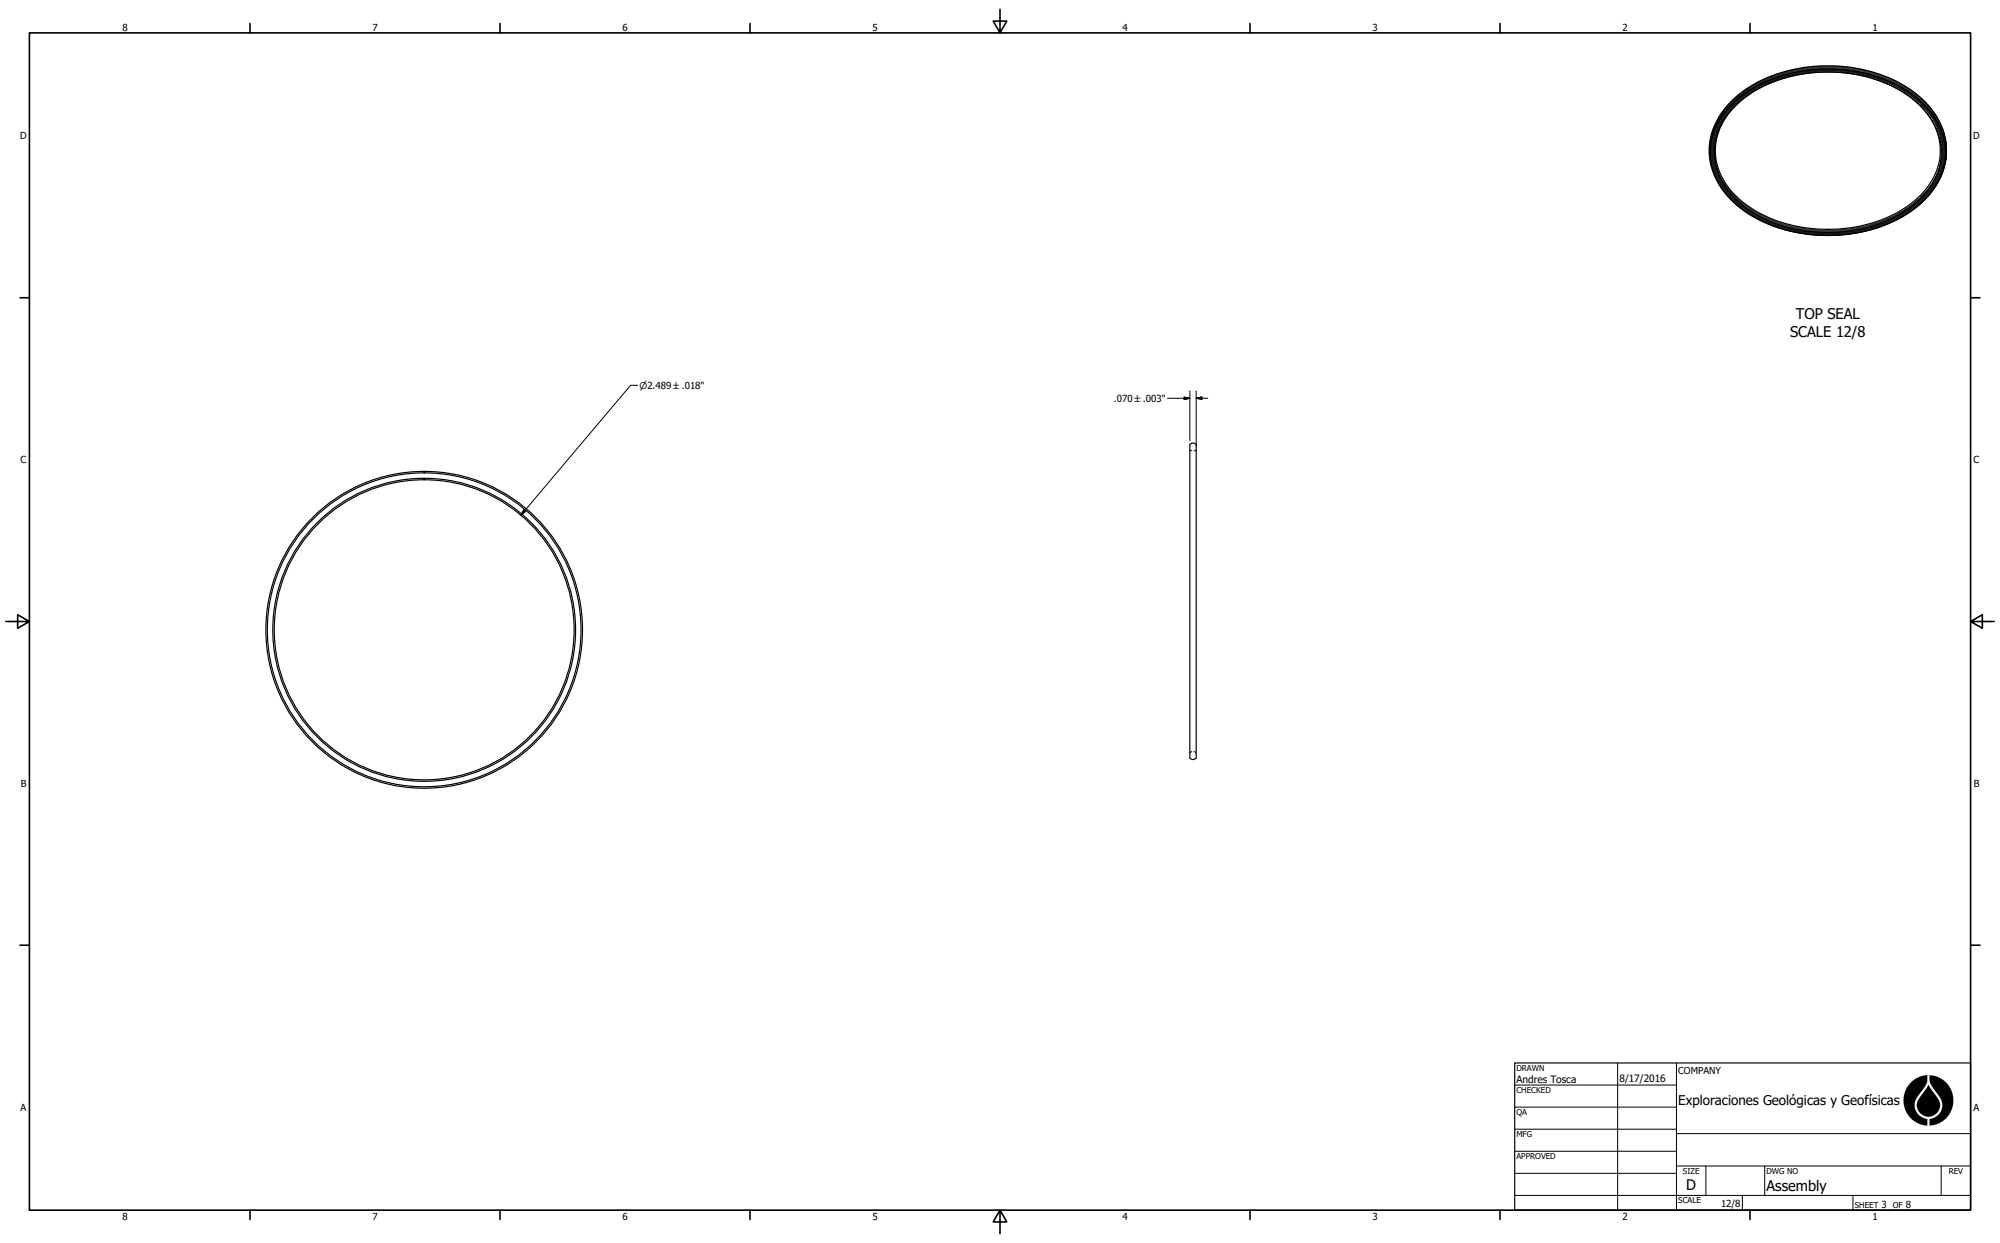
[picture p29: page 3]
TOP SEAL SCALE 12/8; DRAWN; CHECKED; MFG; Andres Tosca; COMPANY

Exploraciones Geolygicas y Geoftsicas

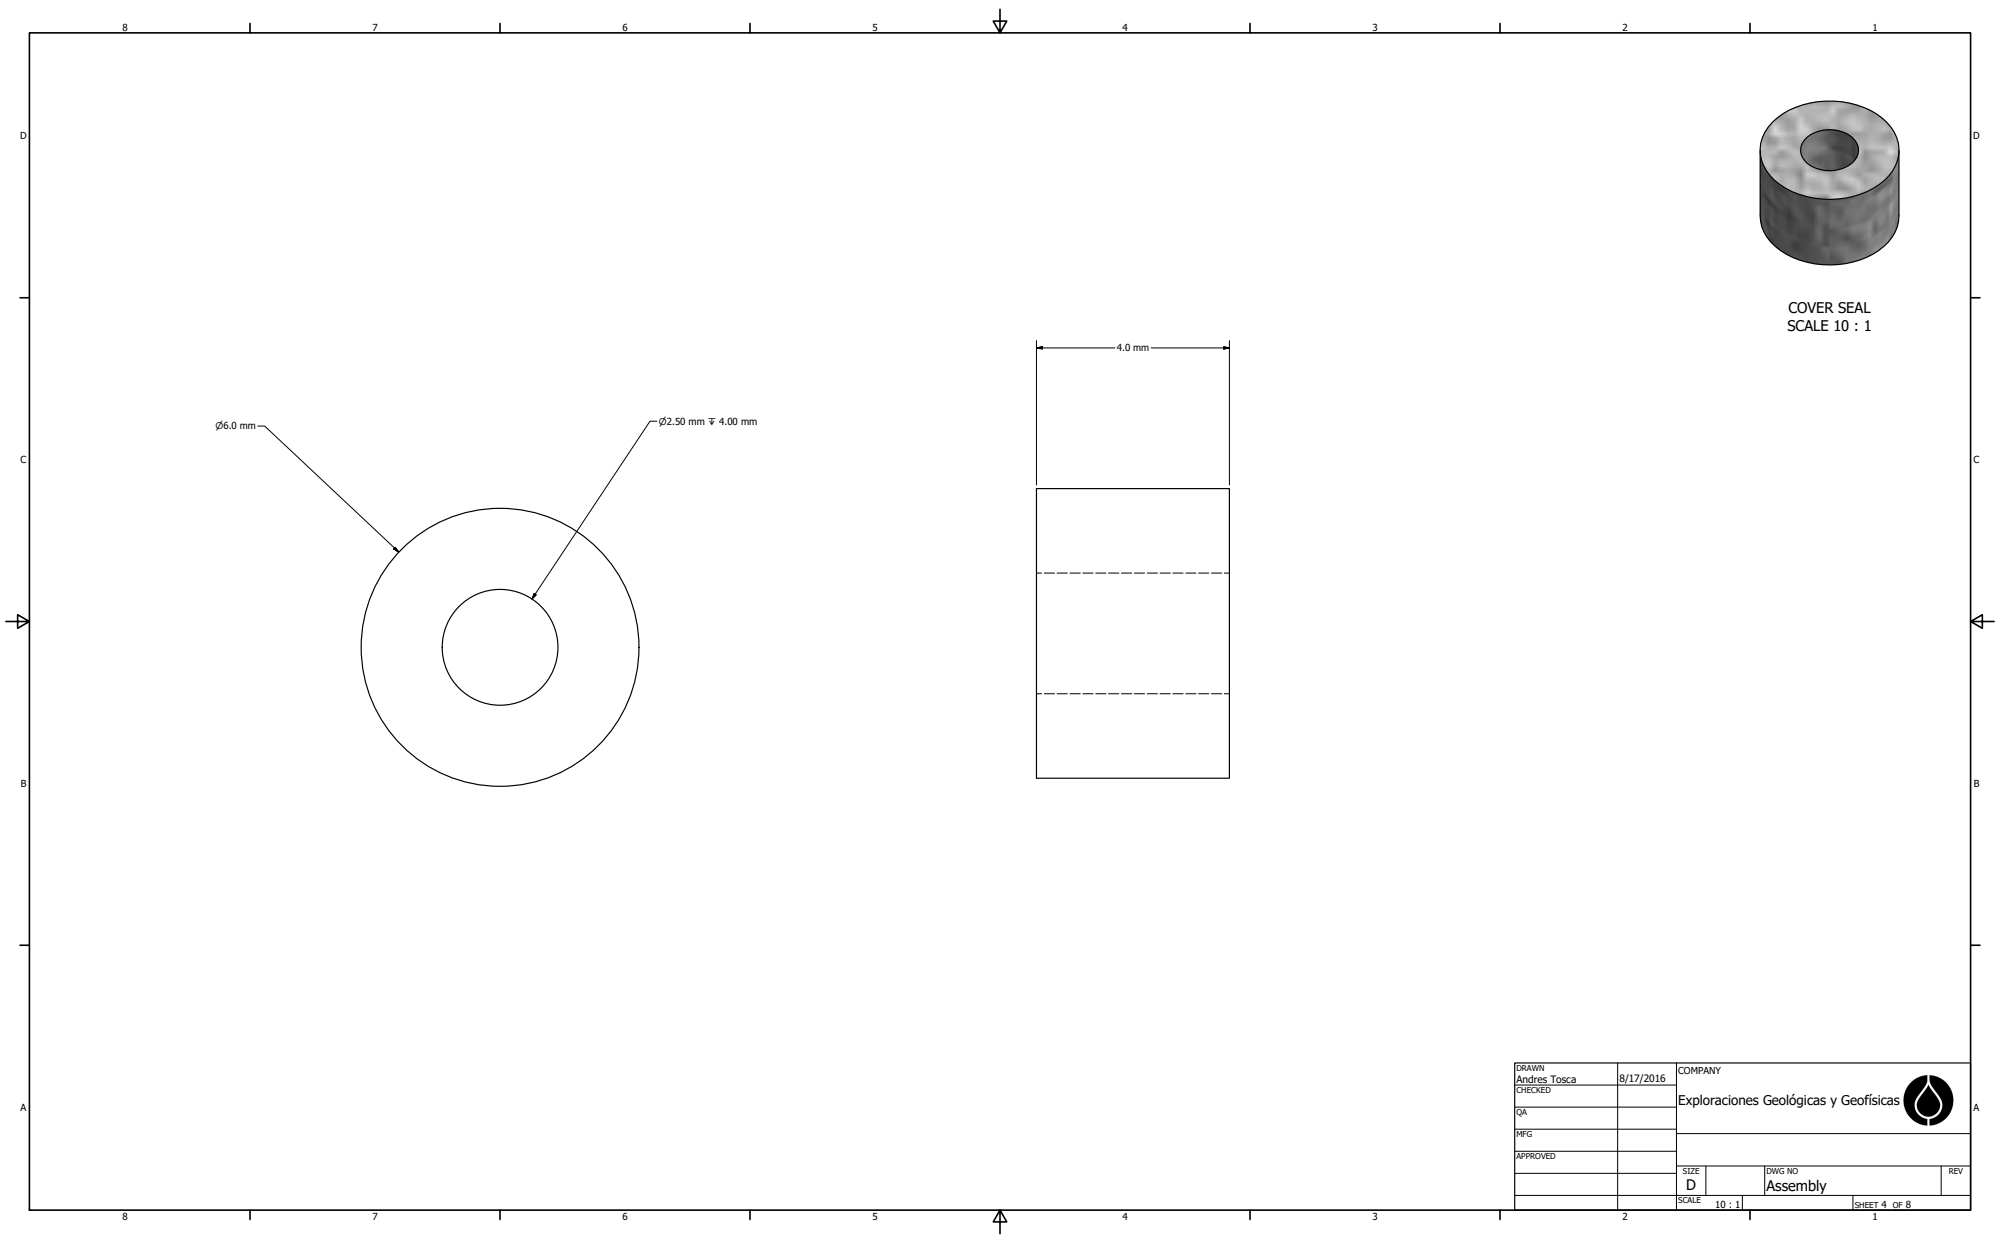
[picture p30: page 4]
COVER SEAL SCALE 10 : 1; DRAWN; CHECKED; MFG; Andres Tosca; COMPANY

Exploraciones Geolygicas y Geoftsicas

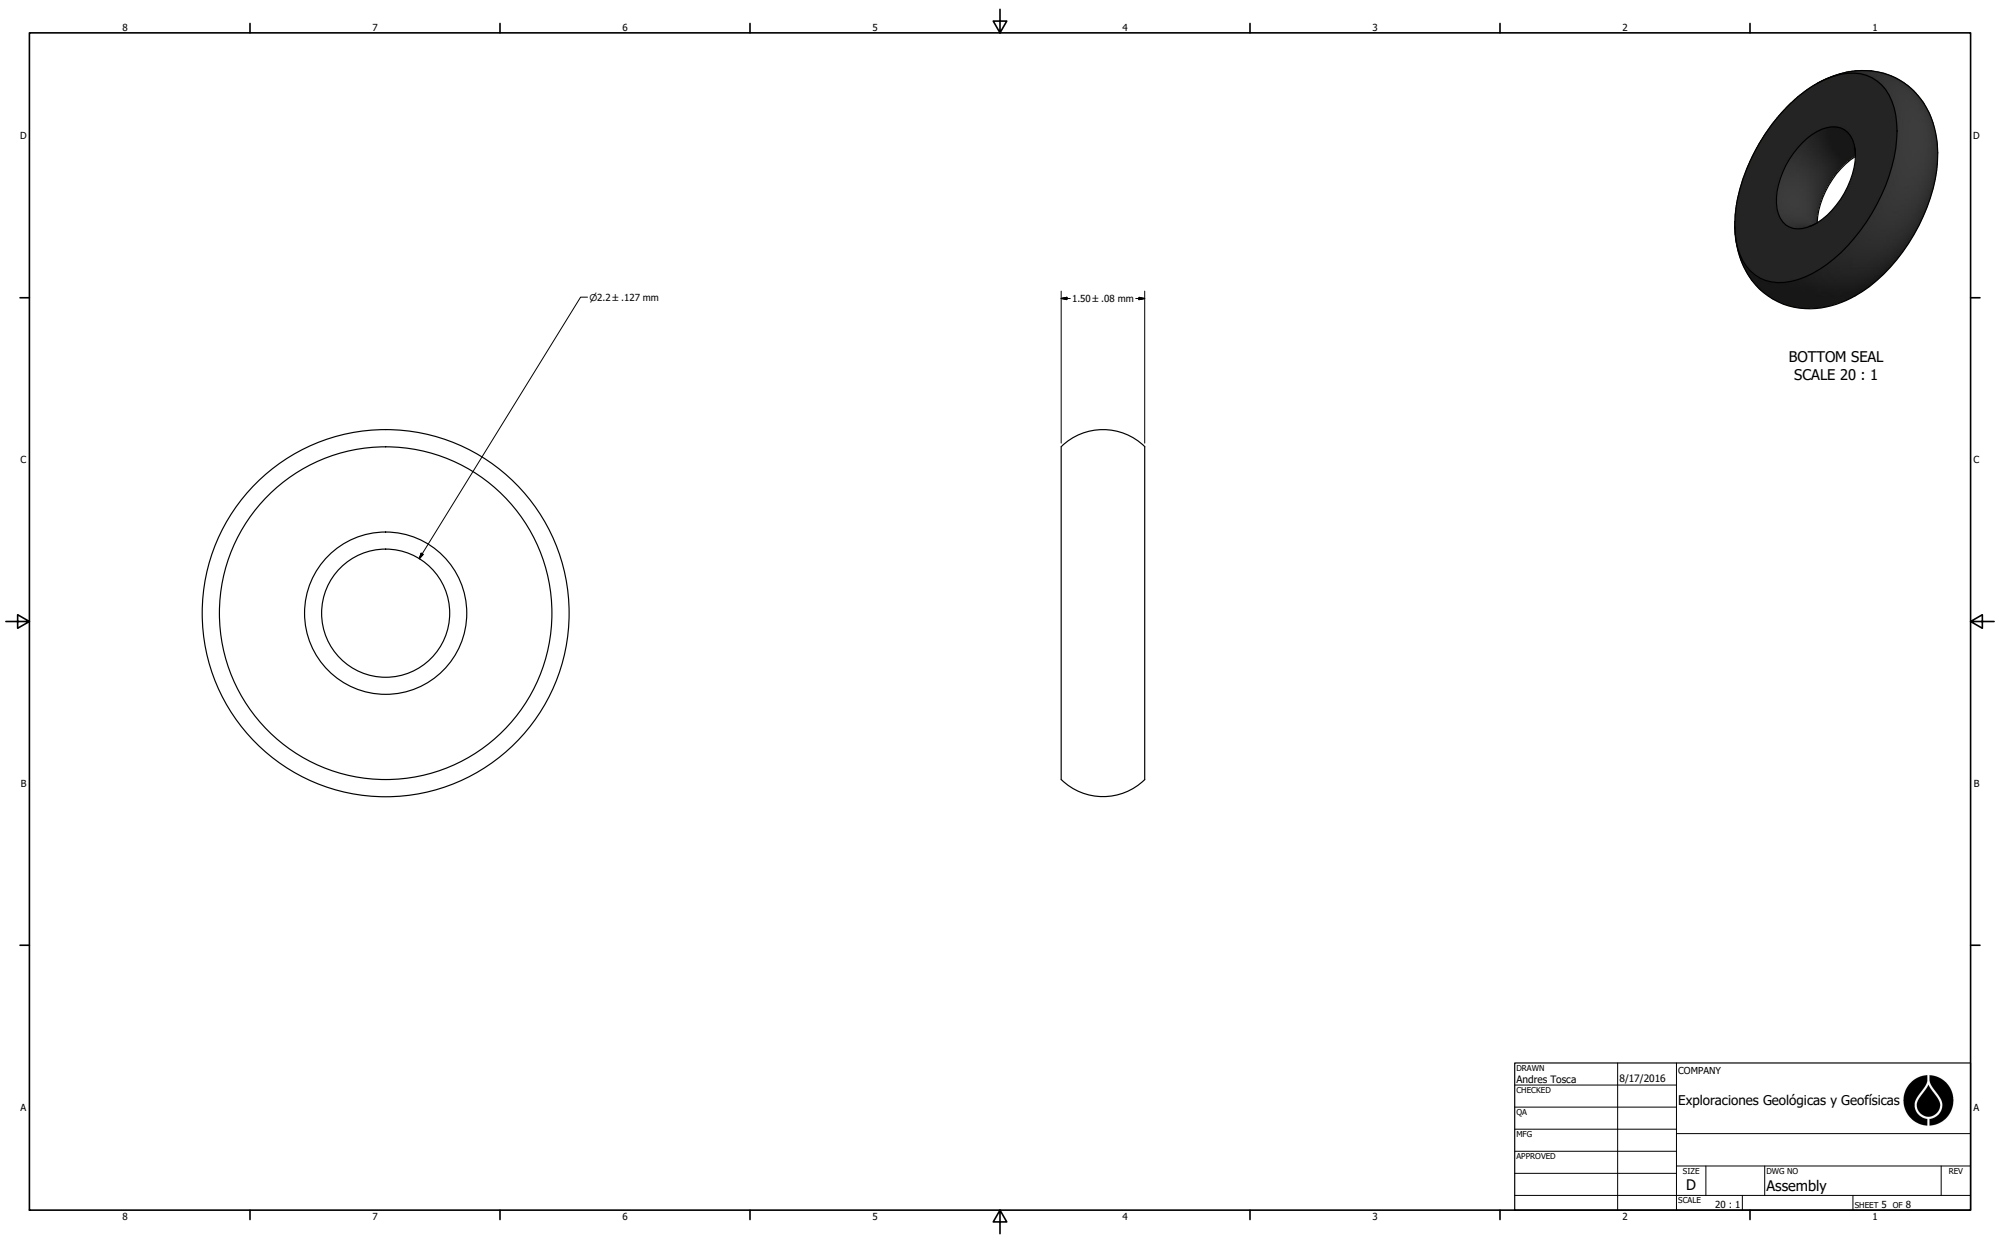
[picture p31: page 5]
BOTTOM SEAL SCALE 20 : 1; DRAWN; CHECKED; MFG; Andres Tosca; COMPANY

Exploraciones Geolygicas y Geoftsicas

## ENCLOSURE SCALE 3 / 4

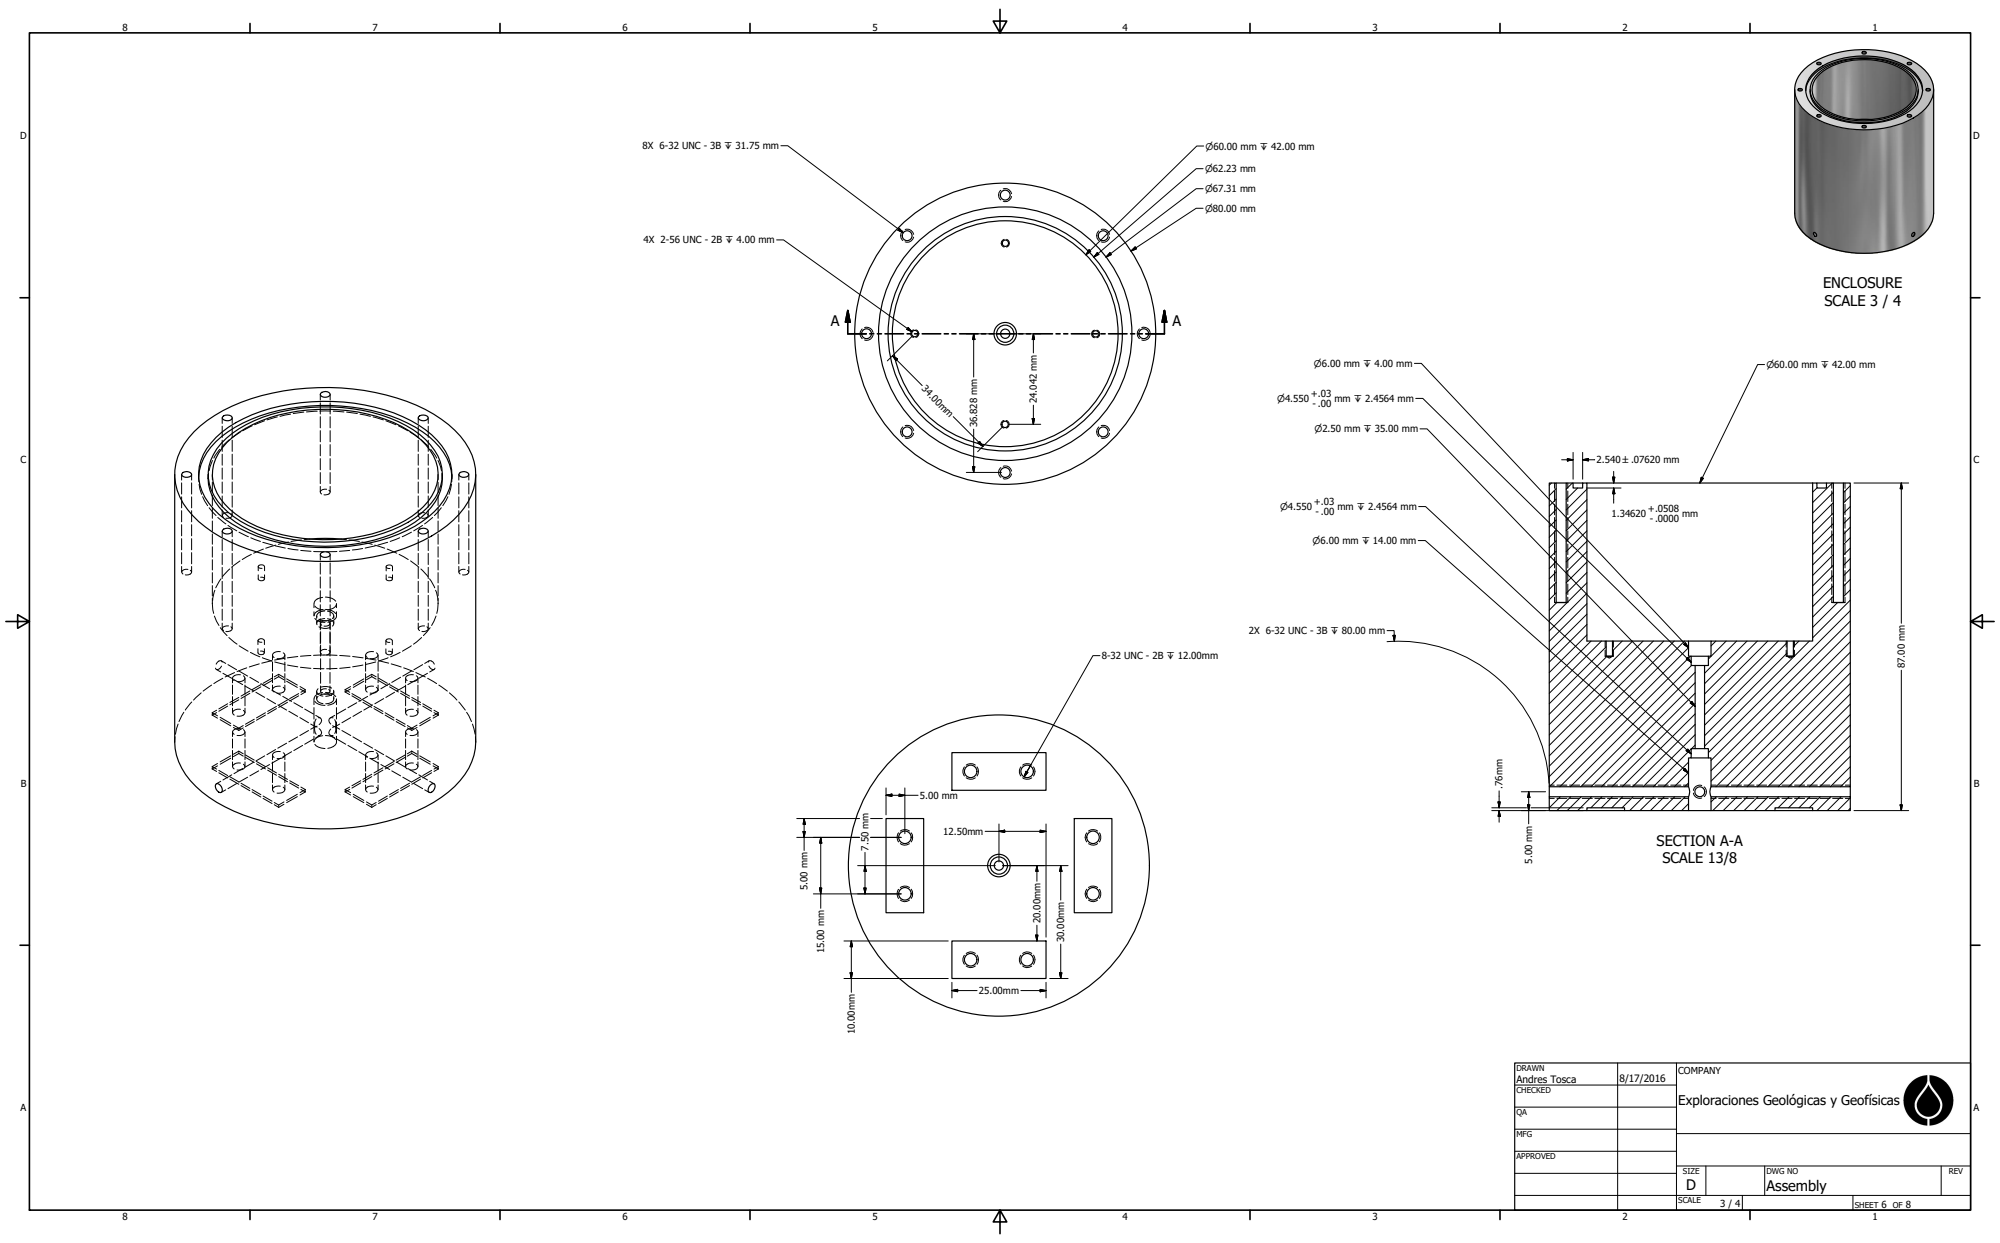
[picture p32: page 6]
SECTION A-A SCALE 13/8; DRAWN; CHECKED; MFG; Andres Tosca; COMPANY; 2X 6-32 UNC - 3B Z 80.00 mm; 8X 6-32 UNC - 3B Z 31.75 mm; 4X 2-56 UNC - 2B Z 4.00 mm; 8-32 UNC - 2B Z 12.00mm

Exploraciones Geolygicas y Geoftsicas

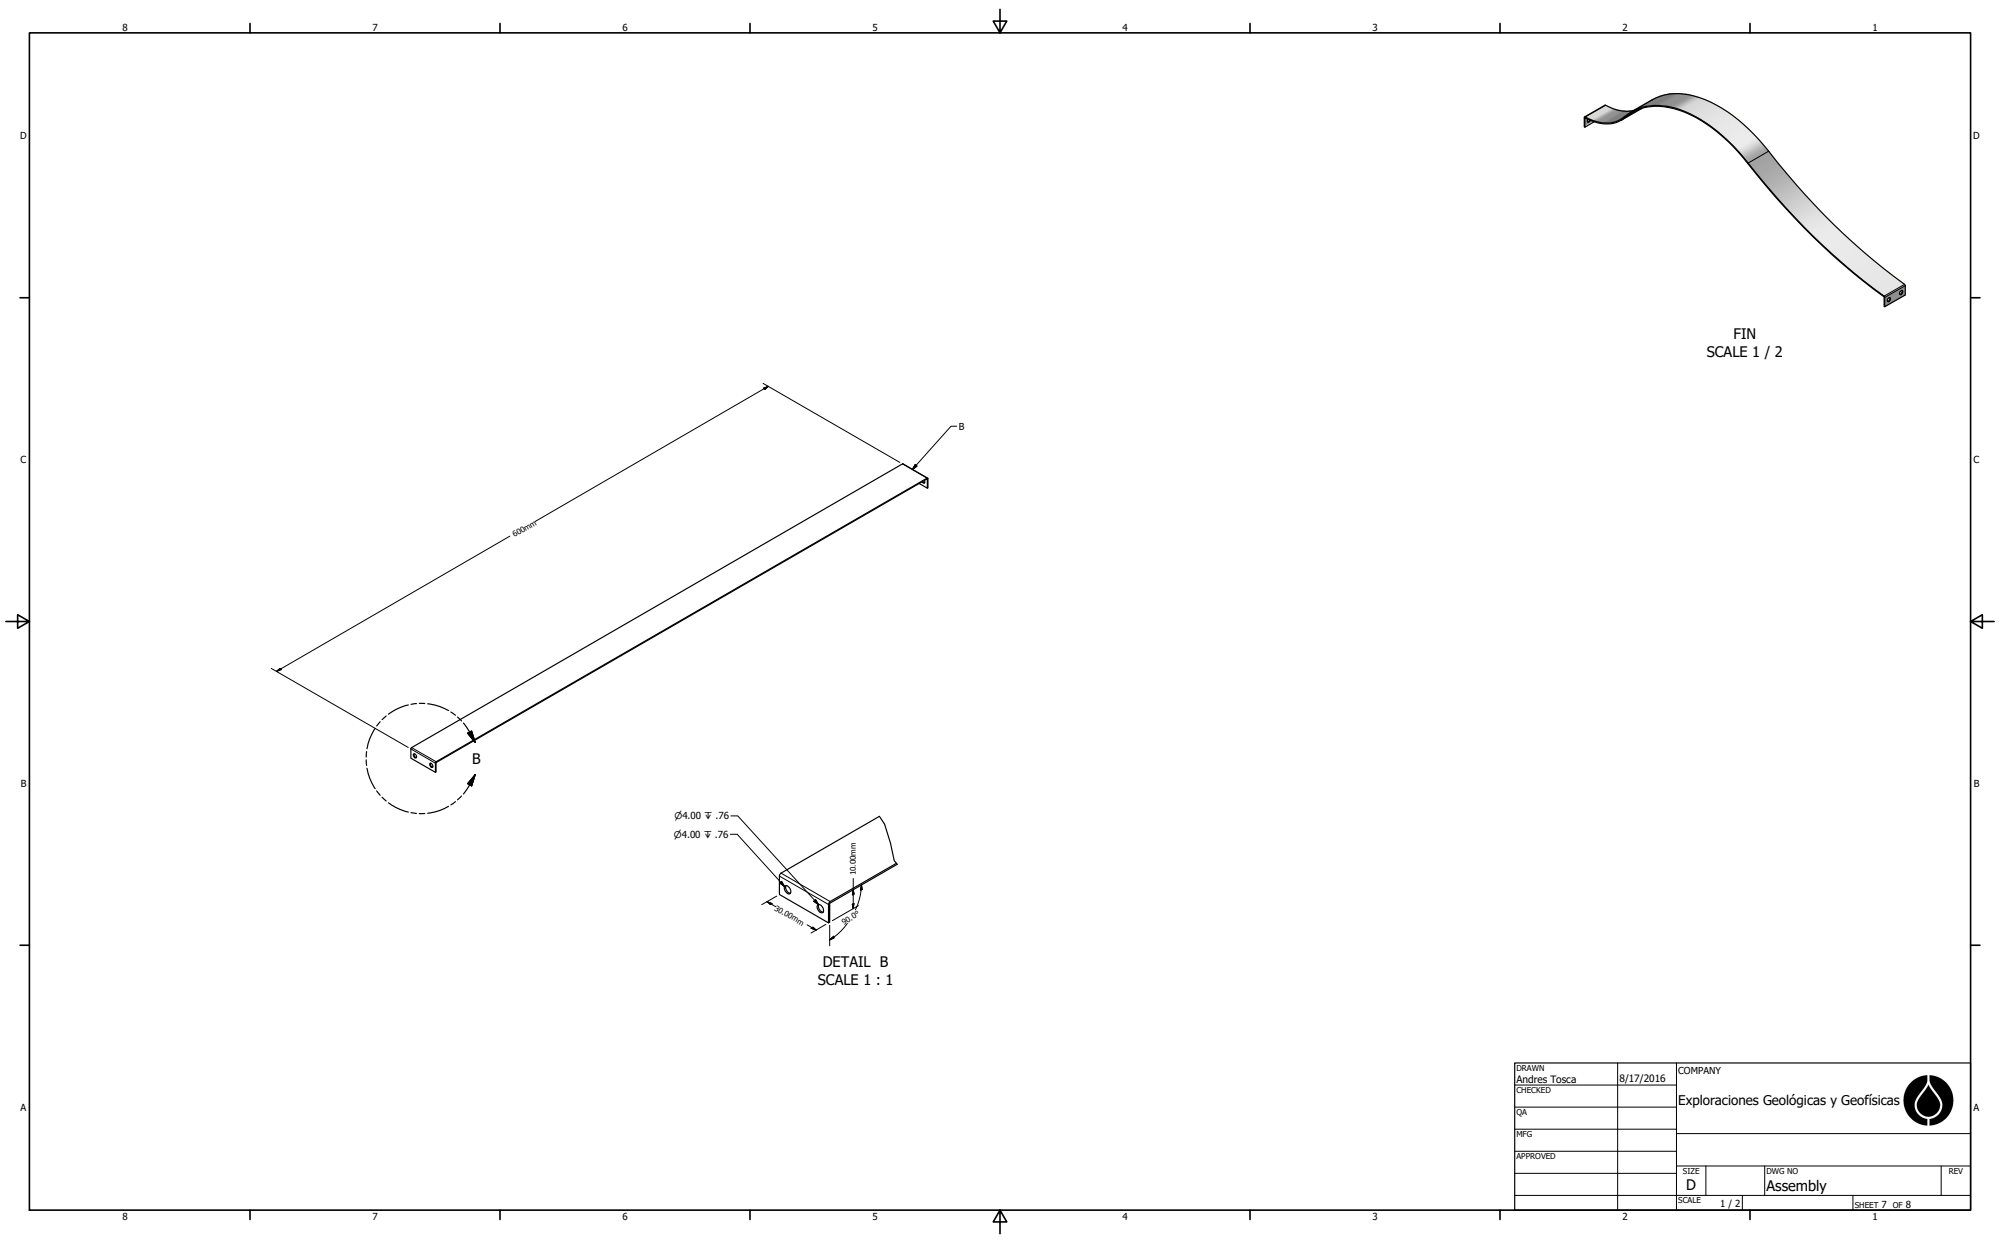
[picture p33: page 7]
FIN SCALE 1 / 2; DETAIL B SCALE 1 : 1; DRAWN; CHECKED; MFG; Andres Tosca; COMPANY

Exploraciones Geolygicas y Geoftsicas

## BOTTOM

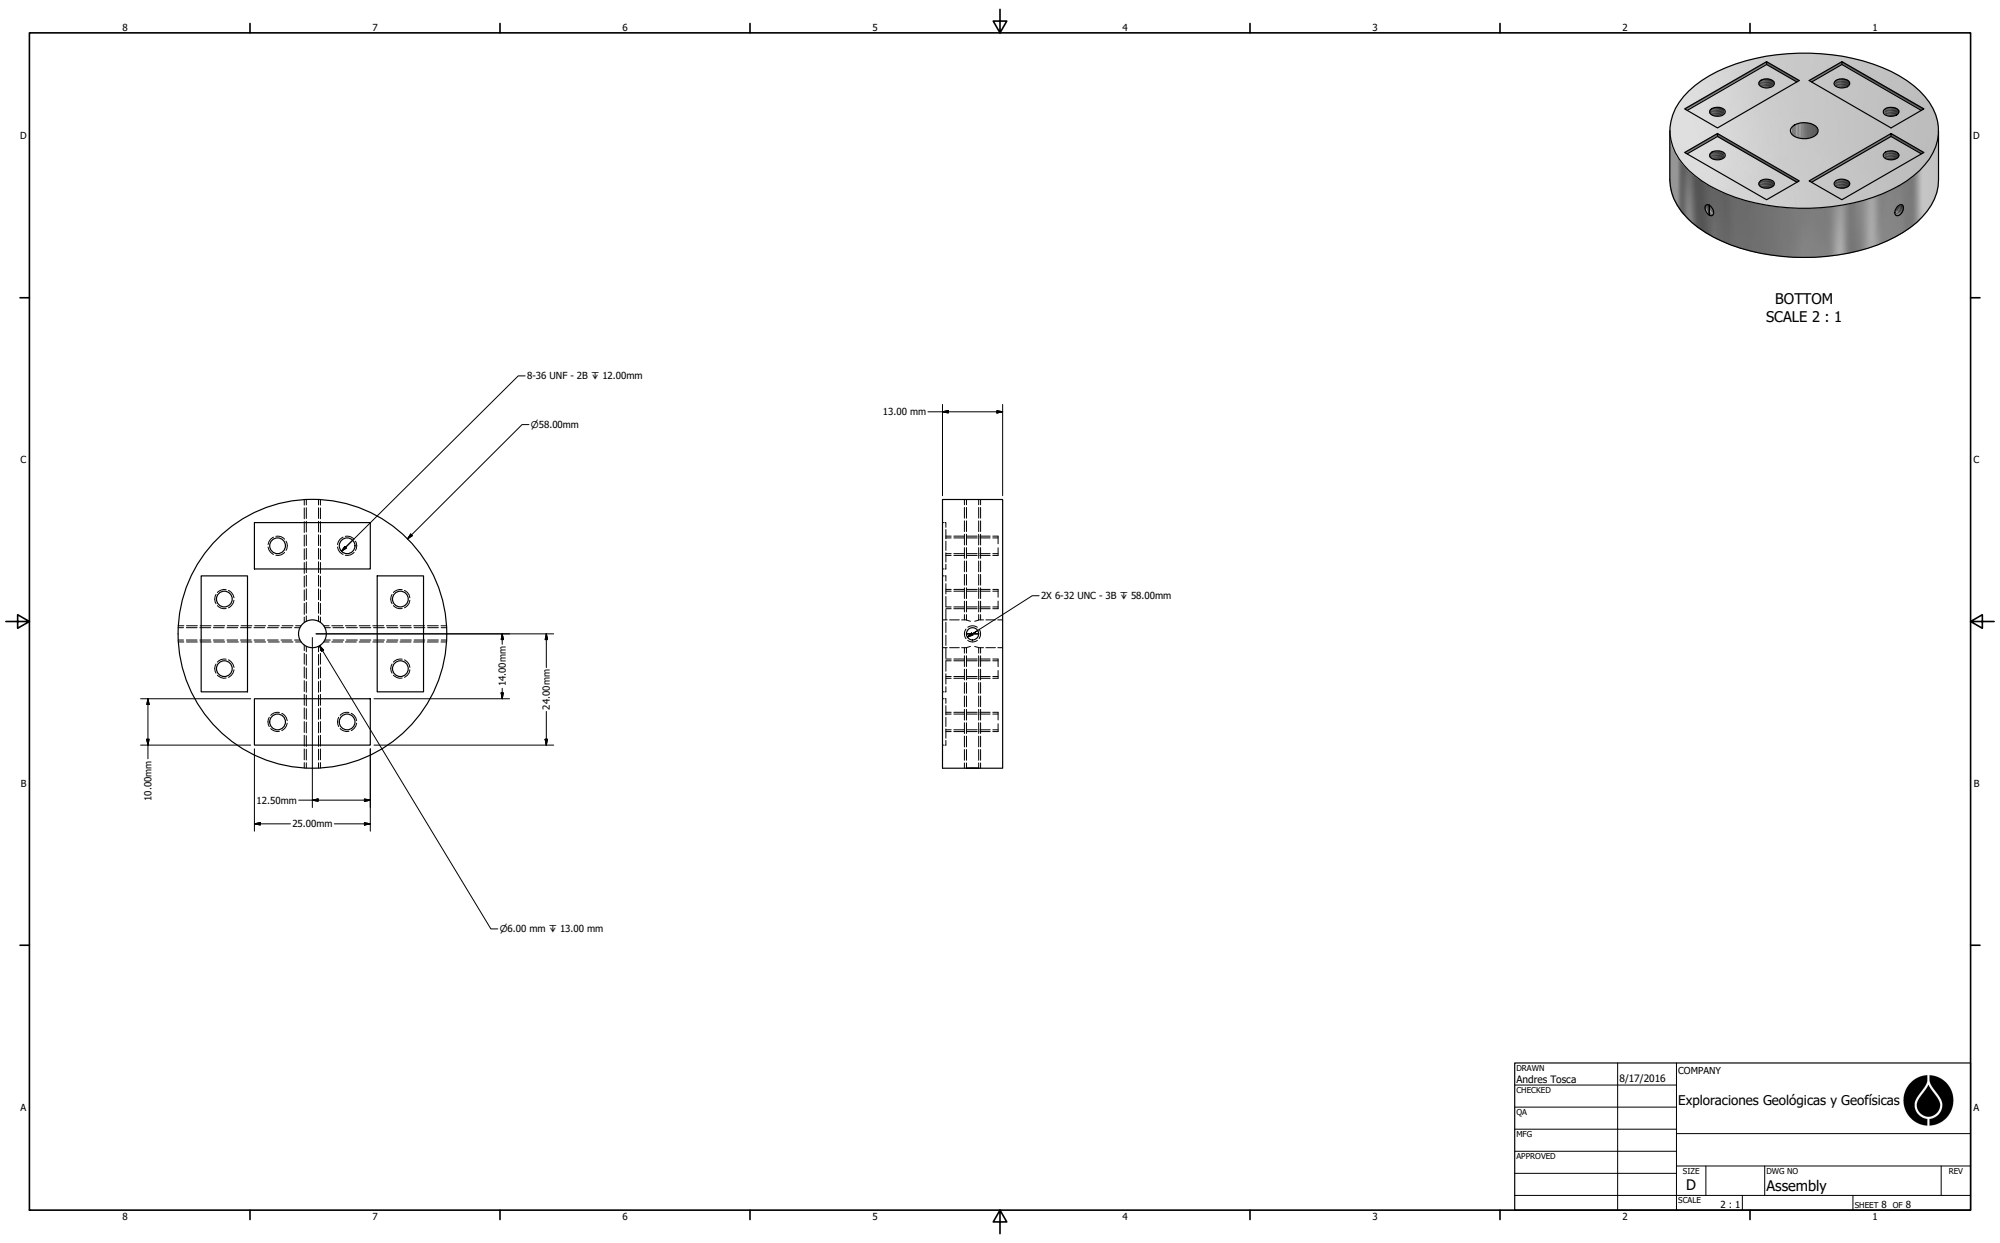
[picture p34: page 8]
SCALE 2 : 1; DRAWN; CHECKED; MFG; Andres Tosca; COMPANY; 2X 6-32 UNC - 3B Z 58.00mm; 8-36 UNF - 2B Z 12.00mm

Exploraciones Geolygicas y Geoftsicas
