andres-tr/BoreholeCamera/PCB_Winch/Job.PDF

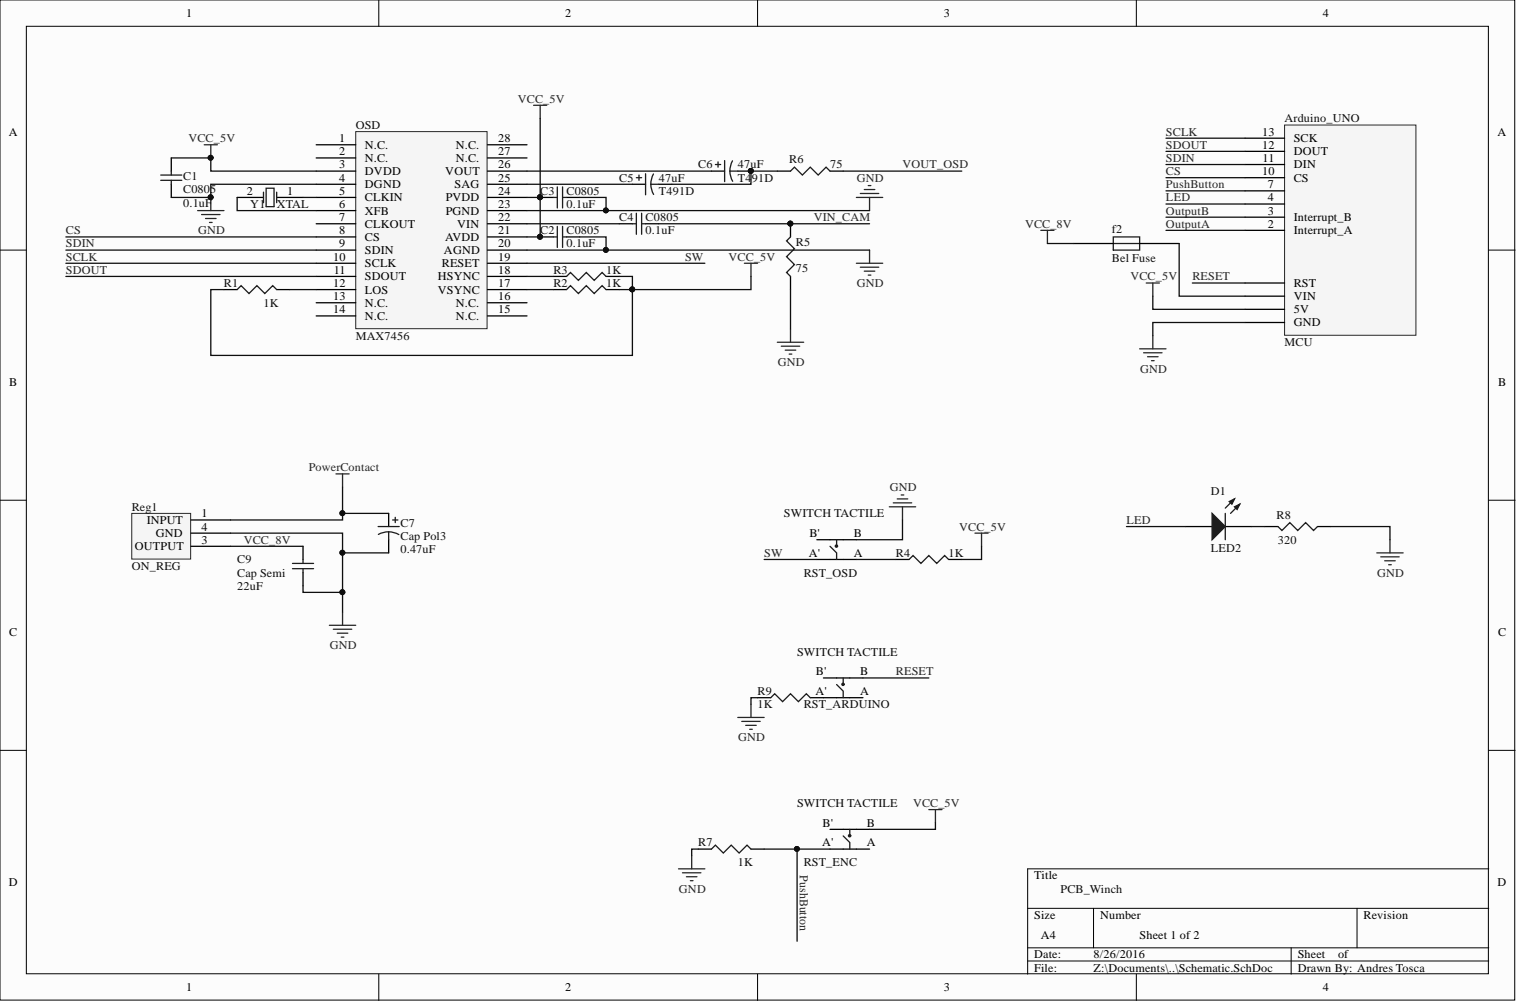
[picture p35: page 1]

DVDD 3
DGND 4
CLKIN 5 | | C3 | C0805

Y1 | XTAL | | XFB 6 | | | 0.1uF

CLKOUT 7 | | | C4 | C0805
CS 8 SDIN 9 SCLK 10 SDOUT 11 LOS 12 | | | C2 | C0805

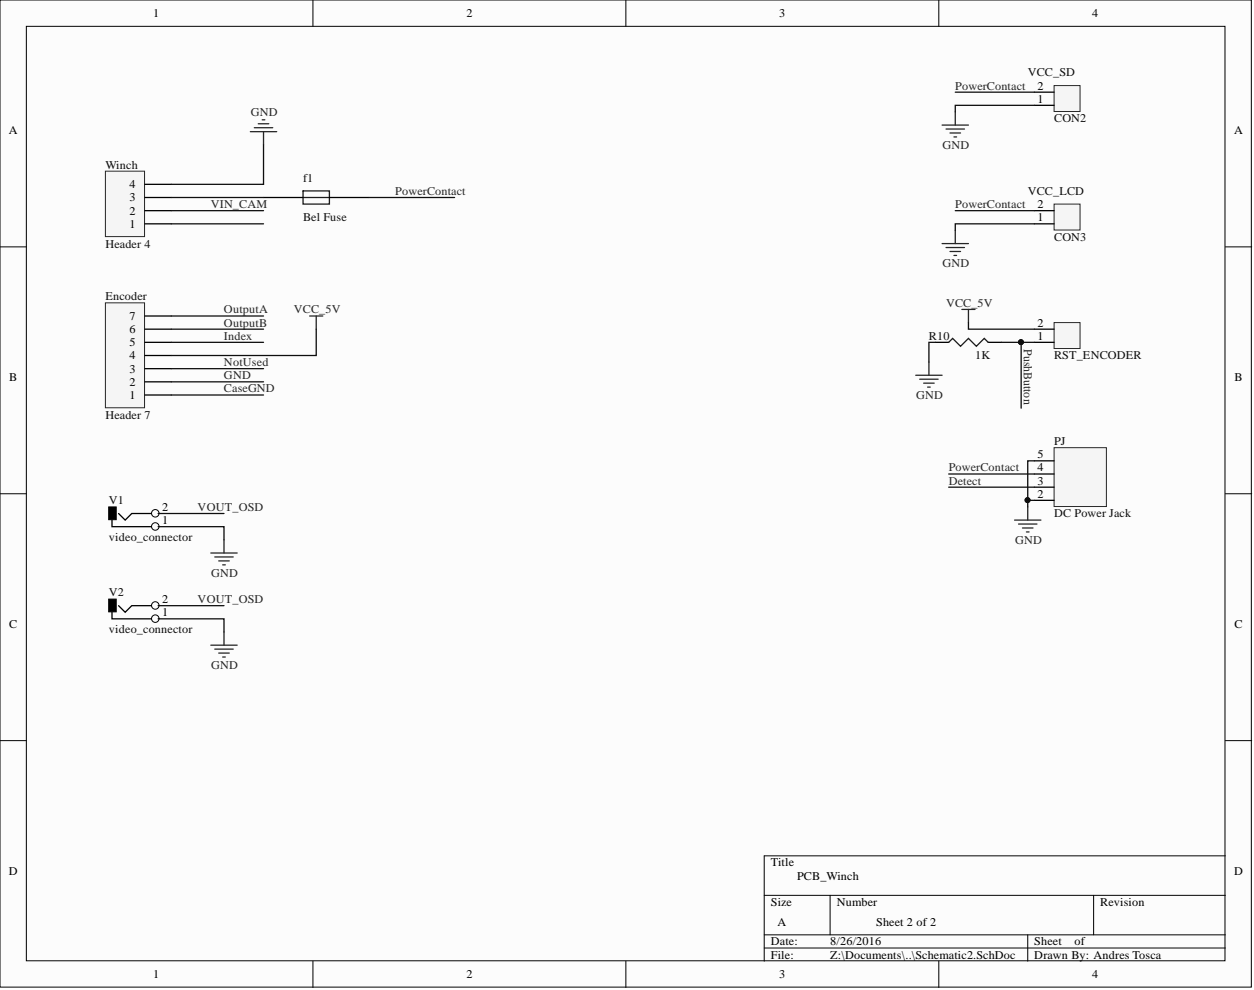
[picture p36: page 2]

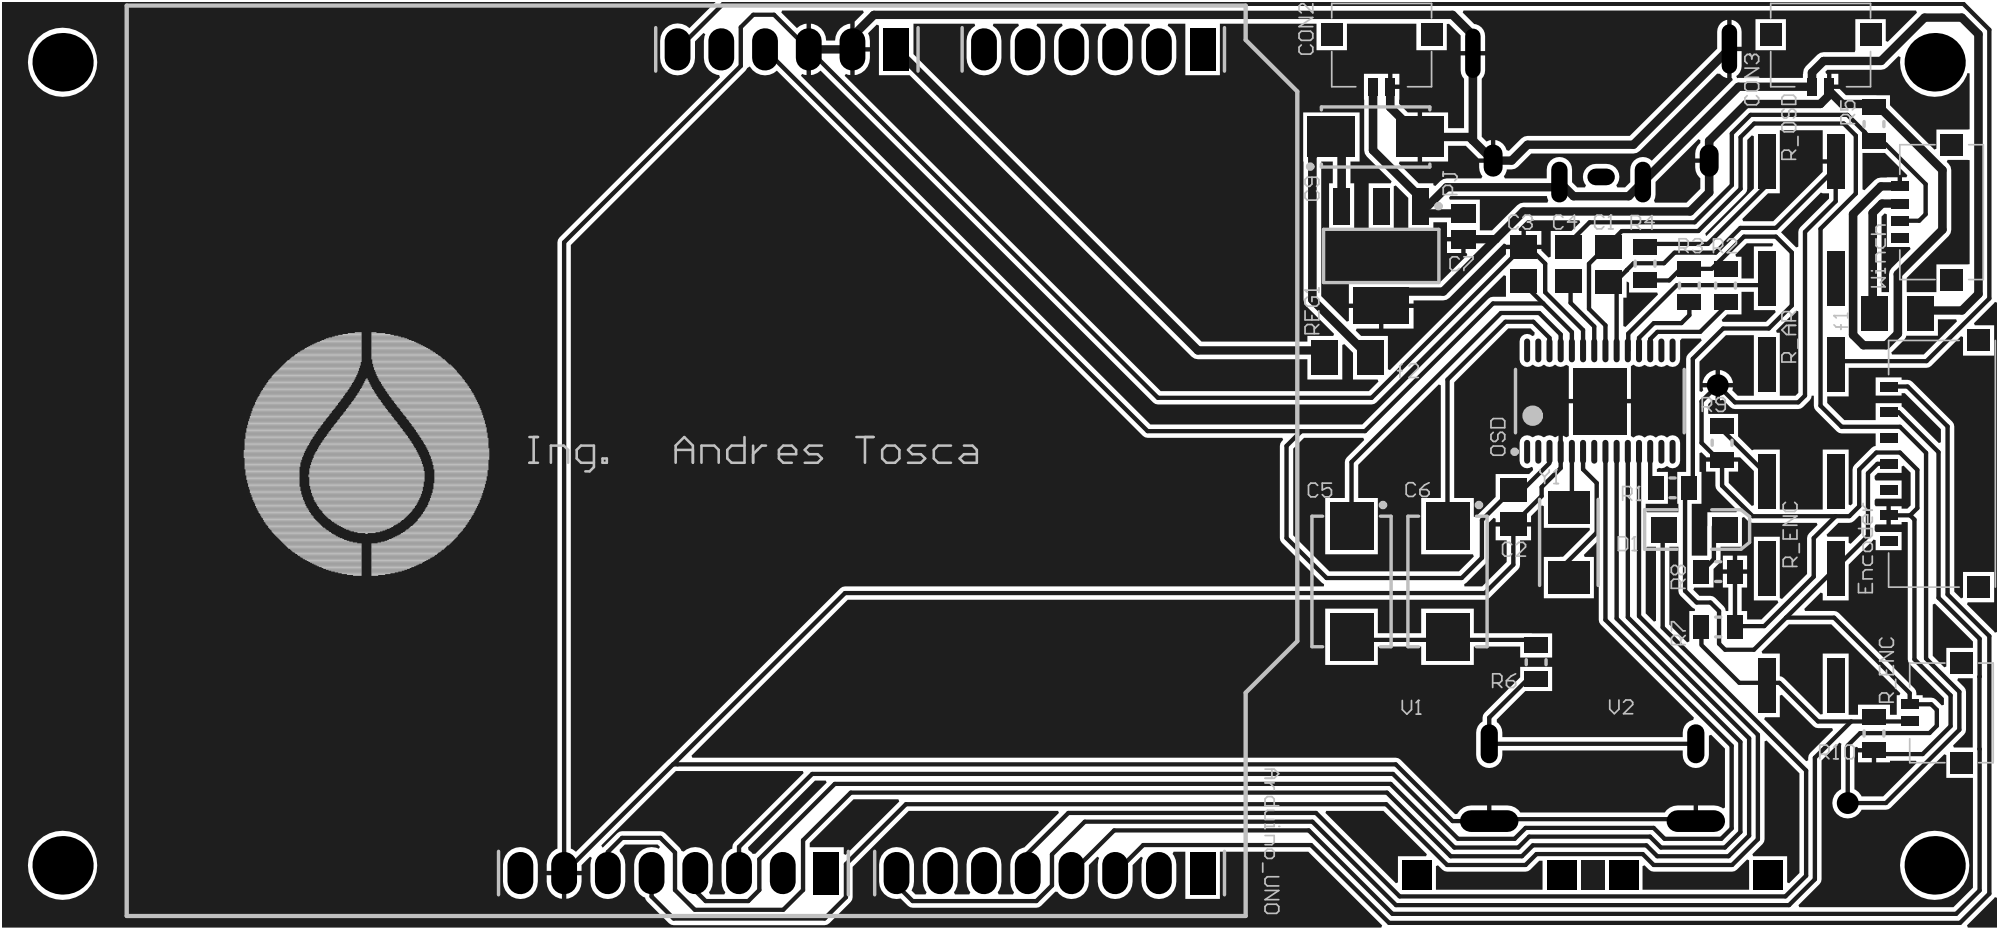
[picture p37: page 3]

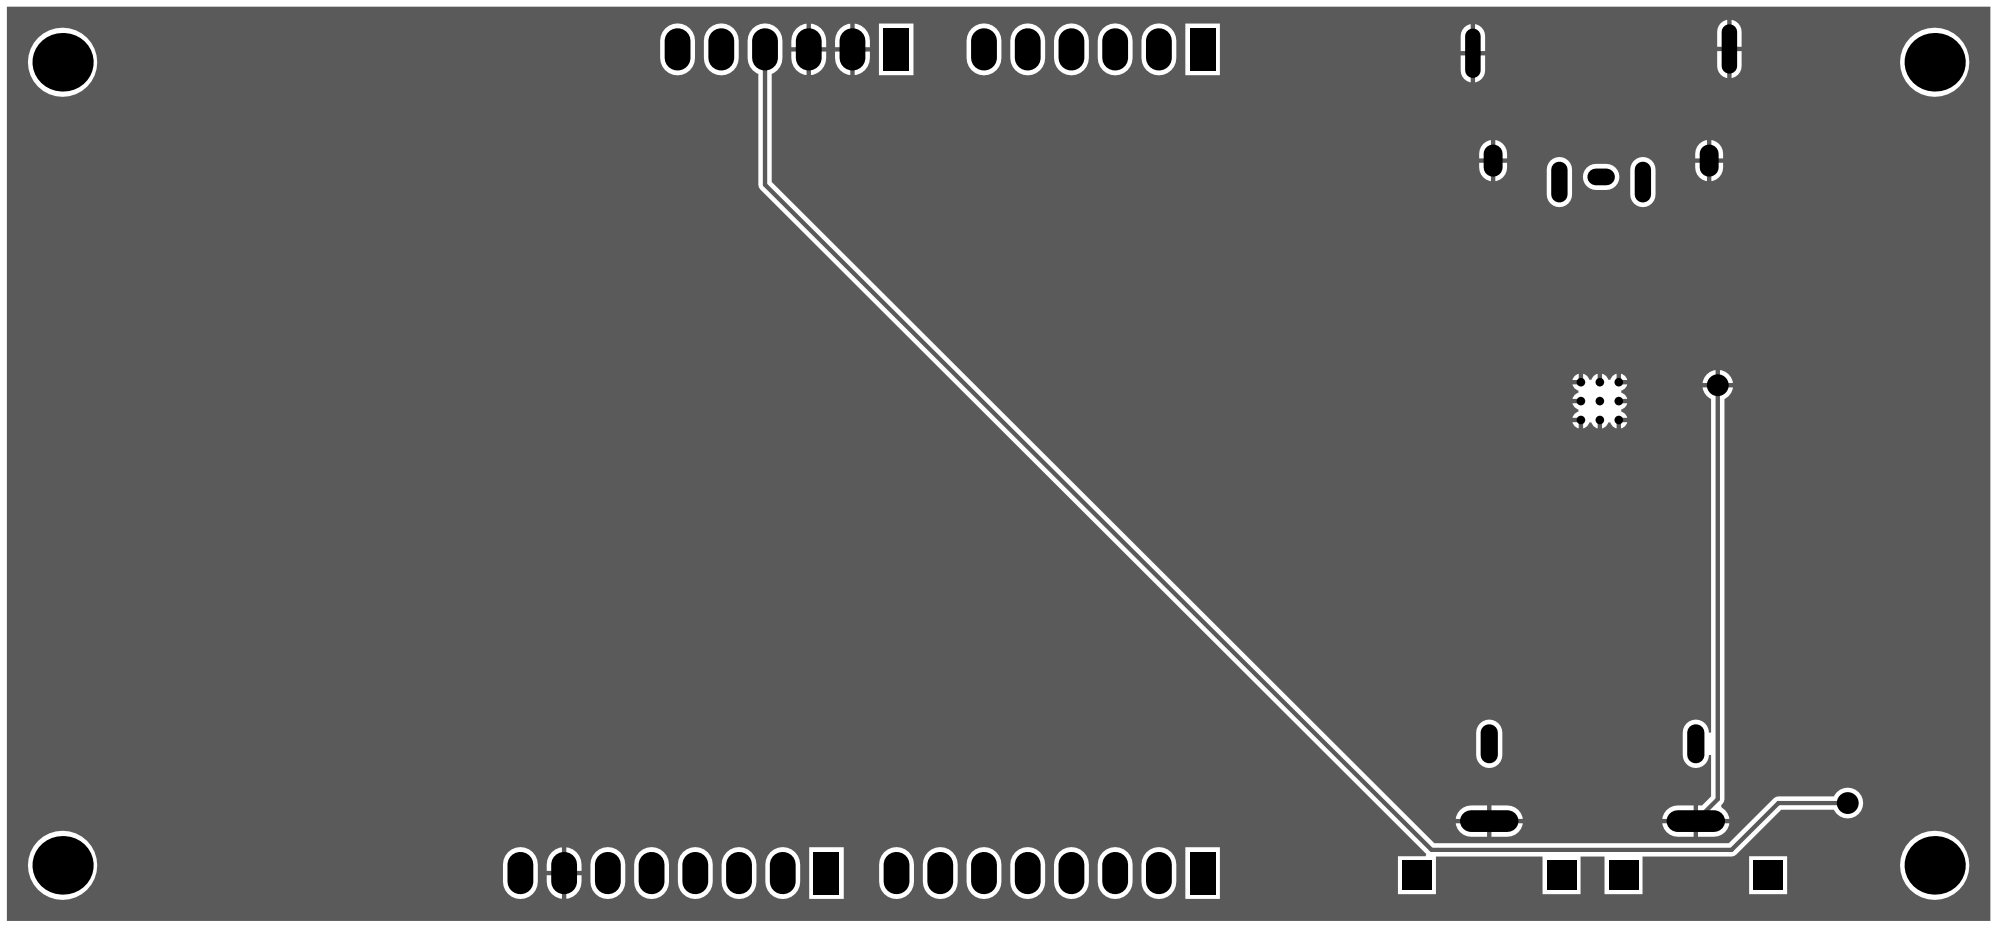
[picture p38: page 4]

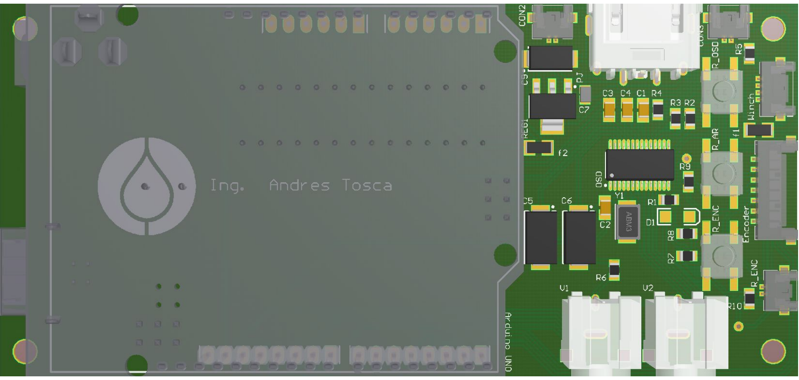
[picture p39: page 5]

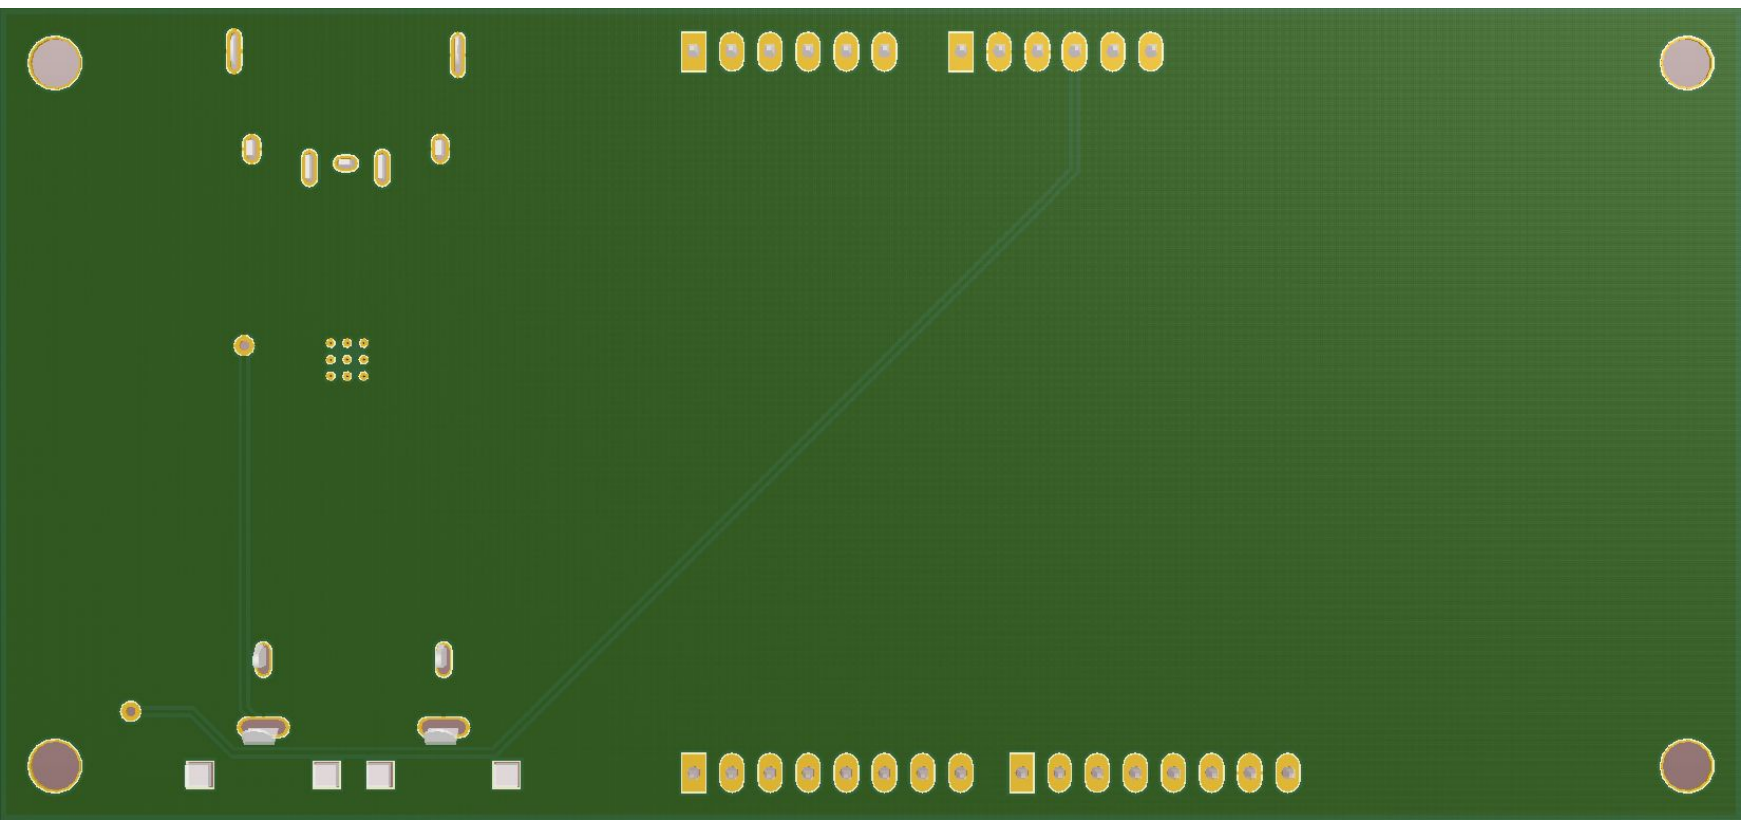
[picture p40: page 6]
