andres-tr/BoreholeCamera/(list of files, drawings)

Other design files:
PCB_Probe/PCB.PcbDoc
PCB_Probe/PCB_Probe.PrjPcb
PCB_Probe/PcbLib.PcbLib
PCB_Probe/Schematic.SchDoc
PCB_Probe/Schlib.SchLib
PCB_Winch/PCB.PcbDoc
PCB_Winch/PCB_Winch.PrjPcb
PCB_Winch/PcbLib.PcbLib
PCB_Winch/Schematic2.SchDoc
PCB_Winch/Schematic.SchDoc
PCB_Winch/Schlib.SchLib
