andres-tr/BoreholeCamera/(commit log)

2001-01-01 updating PCB files
    [PCB.PcbDoc, PCB_Probe.PrjPcb]
2016-01-21 adding PCB file and MAX7456 footprint to PCBlib for creating a breadboard adapter
    [BoreholeCamera.PrjPcb, BreadboardAdapter(MAX7456).PcbDoc, PcbLib.PcbLib, Schematic.SchDoc, Schlib.SchLib]
2016-01-21 Deleting some files and adding a new component to the library
    [BoreholeCamera.PrjPcb, BreadboardAdapter(MAX7456).PcbDoc, PCB.PcbDoc, Schlib.SchLib]
2016-02-02 organizing files because it is going to be difficult if it is created different PCBs on the same project
    [PCB.PcbDoc, PCB_Probe.PrjPcb, PCB_Winch.PrjPcb, PcbLib.PcbLib, Schematic.SchDoc, Schlib.SchLib]
2016-02-11 Adding temperature and led package
2016-02-25 Adding .PCBDoc and libraries, still to fix some errors on the PCB
    [PCB.PcbDoc, PcbLib.PcbLib, Schlib.SchLib]
2016-02-25 PCB ready for a homemade test
    [PCB.PcbDoc, PcbLib.PcbLib]
2016-03-04 Fixing errors on PCB winch and PCB probe finished and ready to make a test at home
    [PCB.PcbDoc, PCB_Probe.PrjPcb, PcbLib.PcbLib, Schematic.SchDoc, Schlib.SchLib]
2016-04-13 Defining size and orientation of components, generating .step file.
    [PCB.PcbDoc, PCB_Probe.PrjPcb, PcbLib.PcbLib, Schematic.SchDoc]
2016-04-14 Adding readme file for CAD probe
    [PCB.PcbDoc]
2016-04-14 Adding CAD parts and ignoring OldVersions directory
    [Assembly.iam, Assembly.stl, Assembly.stp, Camera.ipt, Camera.stl, Camera.stp, PCB_Camera.ipt, PCB_Camera.stl]
2016-04-22 Adding Gif file of exploded assembly. Updating CAD files.
    [Assembly.iam, Bolted Connection1.iam, Bolted Connection2.iam, Clamp.ipt, ClampCover.ipt, Cover.ipt, Enclosure.ipt, PCB_Probe.stl]
2016-04-22 Adding STL file of enclosure assembly
    [Assembly.stl]
2016-05-02 Probe PCB finshed but still to fix voltage regulator problem. Updating connectors and creating footprints on winch PCB
    [Assembly.iam, PCB.PcbDoc, PCB_Winch.PrjPcb, PcbLib.PcbLib, Schematic.SchDoc, Schlib.SchLib]
2016-05-04 Changing enclosure shape to a cylinder and explaining new issues
    [8inch_Fin.ipt, Assembly.iam, ClampCover.ipt, Cover.ipt, Enclosure.ipt]
2016-05-04 Adding stl assembly file and fixing README image problem
    [Assembly.stl]
2016-05-04 Adding enclosure STL files
    [8inch_Fin.stl, Enclosure.stl]
2016-05-05 Updating Assembly files
    [Assembly.iam]
2016-05-05 Adding new way to hold fins
    [Enclosure.ipt]
2016-05-05 Adding STL files
    [Assembly.iam, Assembly.stl, Enclosure.stl]
2016-05-08 Adding PCB BOM
    [BOM_PCB_Probe.xls, BOM_PCB_Winch.xls]
2016-05-08 Update Schematic PCB_Probe
    [PCB_Winch.PrjPcb, Schematic.SchDoc]
2016-05-19 Added voltage regulator and logo, screw hole size to be defined
    [BOM_PCB_Probe.xls, BOM_PCB_Winch.xls, PCB.PcbDoc, PcbLib.PcbLib, Schematic.SchDoc, Schlib.SchLib]
2016-05-22 Fixing README and adding PCB images
    [PCB.PcbDoc]
2016-05-26 Updating PCB_Winch
    [PCB_Winch.PrjPcb, Schematic.SchDoc, Schematic2.SchDoc, Schlib.SchLib]
2016-05-28 update PCB_winch
    [Schematic.SchDoc, Schematic2.SchDoc]
2016-05-30 Update PCB Winch
2016-06-01 Updating PCBs
    [PCB.PcbDoc, PCB_Probe.PrjPcb, PCB_Winch.PrjPcb, PcbLib.PcbLib, Schematic.SchDoc, Schematic2.SchDoc]
2016-06-01 Update PCB probe and winch and some CAD files.
    [PCB.PcbDoc, PCB_Probe.PrjPcb, PCB_Winch.PrjPcb]
2016-06-14 Update PCB
    [PCB.PcbDoc, PCB_Probe.PrjPcb, PCB_Winch.PrjPcb]
2016-06-25 Update img and CAD files
    [8inch_Fin.ipt, 8inch_Fin.stl, Assembly.iam, Bolted Connection1.iam, Bolted Connection2.iam, Bottom.ipt, Bottom.stl, Clamp.ipt]
2016-07-05 Adding drawing files
    [Assembly1.iam, Drawing.idw, Explosion.ipn]
2016-07-28 Removing Shaft collar, adding top seal and adding fasteners to CAD
    [90910A680_LOW-PROFILE BUTTON HEAD TORX MACHINE SCREW.STEP, 90910A680_LOW-PROFILE BUTTON HEAD TORX MACHINE SCREW.ipt, 91075A212_18-8 SS MALE-FEM THRDED HEX STANDOFF.STEP, 91075A212_18-8 SS MALE-FEM THRDED HEX STANDOFF.ipt, Assembly.iam, Assembly1.iam, Cover.ipt, Drawing.idw]
2016-07-28 Changin <24 mils drills to 24 mils
    [PCB.PcbDoc, PcbLib.PcbLib]
2016-07-28 Adding CAD BOM
    [BOM_Enclosure_Probe.xls]
2016-07-28 Enclosure BOM update
    [BOM_Enclosure_Probe.xls]
2016-08-15 Making changes to BOM files, adding drawing of enclosure, fixing Camera CAD dimensions
    [Assembly.iam, BOM_Enclosure_Probe.xls, BOM_PCB.xls, BOM_PCB_Probe.xls, BOM_PCB_Winch.xls, Camera.ipt, Enclosure.dwg, PCB_Camera.ipt]
2016-08-16 Fixing gland o-ring, updating CAD PCB_Camera size, adding fasteners and making changes on the way the fins are attached to the enclosure
    [8inch_Fin.ipt, 90910A680_LOW-PROFILE BUTTON HEAD TORX MACHINE SCREW.ipt, 91075A212_18-8 SS MALE-FEM THRDED HEX STANDOFF.ipt, 91115A816_18-8 SS FEM THRDED HEX STANDOFF.ipt, 92185A071_TYPE 316 SS SOCKET HEAD CAP SCREW.ipt, 92313A154_TYPE 316 SS CUP POINT SET SCREW.ipt, 92785A148_HIGH HOLD CONE POINT SET SCREW.ipt, Assembly.iam]
2016-08-18 Assembly updated with all fasteners, updating BOM_Enclosure and creating drawing files
    [Assembly.dwg, Assembly.iam, Assembly1.iam, BOM_Enclosure_Probe.xls, Explosion.ipn]
2016-08-25 Updating Drawing files
    [Assembly.dwg]
2016-09-02 Updating BOM Enclosure
    [BOM_Enclosure_Probe.xls]
2016-09-10 Updating BOM file
    [BOM_Enclosure_Probe.xls]
2016-09-23 Updating files before changing the design
    [8inch_Fin.ipt, 92313A412_TYPE 316 SS CUP POINT SET SCREW.STEP, 92313A412_TYPE 316 SS CUP POINT SET SCREW.ipt, AS 568 - DASH # 004(1).ipt, AS 568 - DASH # 201(1).ipt, Assembly.dwg, Assembly.iam, Assembly1.iam]
2016-10-23 Updating Enclosure design
    [8inch_Fin.ipt, Assembly.dwg, Assembly.iam, Assembly1.iam, BOM_Enclosure_Probe.xls, Bottom.ipt, Cover.ipt, Enclosure.ipt]
2016-11-01 Updating the cover desing for improving camera image and updating drawing files
    [8inch_Fin.ipt, Assembly.dwg, Assembly.iam, Assembly1.iam, Bottom.ipt, Cover.iam, Cover.ipt, CoverPart1.ipt]
2016-11-01 Updating Drawing and assembly files
    [Assembly.dwg, Assembly.iam, Assembly1.iam, Cover.iam, tmp.ipn]
2016-11-13 Updating cover design for eliminating light on the lens
    [Assembly.dwg, Assembly.iam, Cover.iam, Cover.ipt, CoverPart1.ipt, CoverPart2.ipt, CoverPart3.ipt, CoverPart4.ipt]
2018-03-28 Agregando codigo del encoder
2018-04-04 Adding video capture code and encoder values to txt
2018-04-21 Adding ROS branch for robot pose using simulated encoder and imu
2018-04-24 Cambiando codigo para leer del encoder, no esta probado de seguro falla, falta arreglar covariancia
    [odometry.py]
2018-05-10 modifying odometry code for not loosing encoder counts
2018-05-21 packages csv to rosbag files and concatenation of IMU messages
2018-07-17 Adding text to video from ip camera
2018-08-20 Adding files for laser enclosure
    [laserCapBottom.f3d, laserCapBottom.stl, laserCapTop.f3d, laserCapTop.stl]
2018-08-21 Thread on laserCapTop and Nut
    [laserCapTop.f3d, laserCapTop.stl, laserNut.f3d, laserNut.stl]
2018-08-21 Adding Nut gcode file
2018-08-21 Nut diameter modified gcode
2018-08-21 Different support for 90 deg angle for laser cap top
2018-08-21 100 percent infill and raft plate adhesion
2018-08-24 Adding laser cap bottom gcode with 100 percent infill
2018-08-24 Adding laser Cap top with more space tolerant for oring and 100 percent infill with raft build plate
2018-08-24 Changing support laser cap top and changing oring place diameter
2018-11-16 Udpadting files, adding CAD file to rviz (still need more work), Z direction and signal for encoder in odometry node, new video node por topic publish, video_cap node truncating float,
    [robot.urdf]
2019-04-28 Current virtual machine stopped working correctly, updating files for moving to a new virtual machine
2021-11-13 updating launch file with correct position of IMU, updating odometry with diferent covariance values
    [odometry.py]
2021-11-18 Adding parameters on imu filter winch launch file
2021-11-23 Fixing Magnetomer bad data from IMU, problem: bad mag register acces
2021-11-23 Adding Odometry big covariance on x and y because winch doesnt has a sensor that measures X and Y position
2021-11-23 Fix for orientantion Z drift by accesing correct mag register, tf for temperature on message
    [imu.py]
2022-02-15 Adding rosbagPlay launch and winch launch with calibration data for hard iron magnetometer
2022-02-15 Adding calibration mag and text output nodes
2022-03-15 Adding little changes and code for calibrating de magnetometer in xz axis
2022-03-15 Adding rosparam to IMU code to make on field calibrations
2022-03-15 imu code tested on robot for parameter input
2022-03-16 Adding scripts of commands always used and adding calibration accelerometer code for dynamic param reconfigure
2022-03-16 Adding changes to in field calibration
2022-03-17 Adding a timeout when comunication interrupts
2022-03-18 Adding timeout for excluding bad data after a connection lost between robot and winch
    [robot.urdf]
